clintonelliott23/CT-Monitoring-Assignment/CTM - Operational Images/20171026_112421.jpg

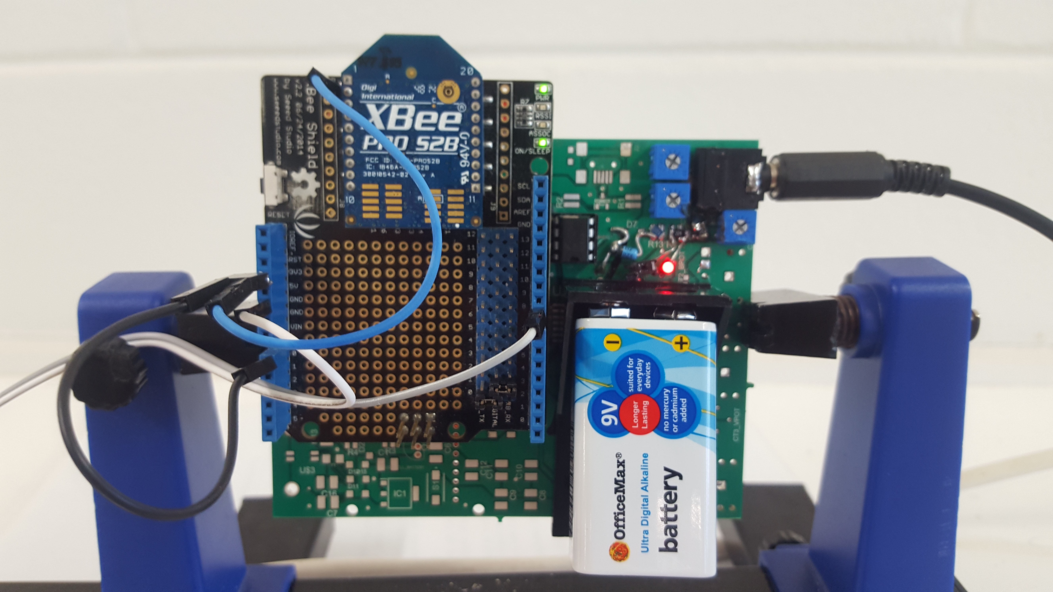
CTM - Operational Images/20171026_112421.jpg
