clintonelliott23/CT-Monitoring-Assignment/CTM - Website HTML Code/CTM-3501 Live Current Sensor (Website)_files/bg3.jpg

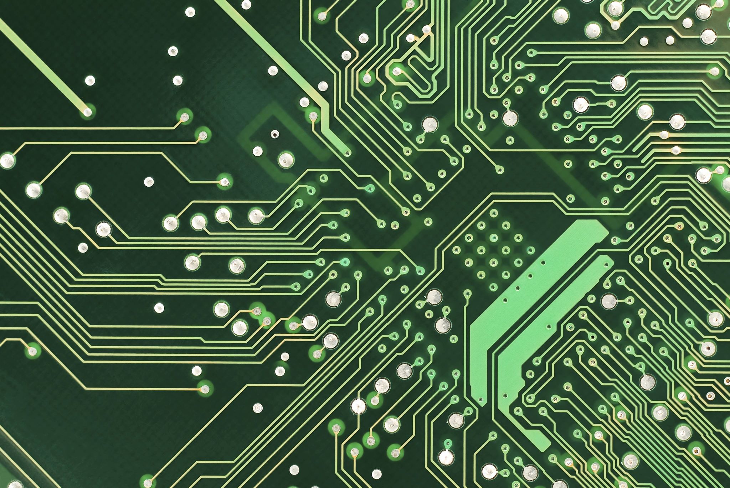
CTM - Website HTML Code/CTM-3501 Live Current Sensor (Website)_files/bg3.jpg
