clintonelliott23/CT-Monitoring-Assignment/CTM - PCB, Schematic & BOM/CC3501-Bill-of-Materials-CT-Metering-PCB_Final.xlsx

EE3501 - CT Metering PCB - Bill Of Materials
 |  |  |  |  |  |  |  |  |  |  | Freedom Schematic |  | C:\Users\Clint\OneDrive\4th Year Sem2\CC3501\Software\FRDM-K20D50M_SCH.pdf
 |  |  |  |  |  |  |  |  | `
Components as listed on Element14:
Order Code | MuF# | Quantity | Part | Description | Size | Mount | Max Voltage | Max Current | Power Draw | Unit price | Total price | Notes | Data Sheets | Element Website
1887096 | MM3Z3V3ST1G | 4 | Zener | ZENER DIODE, 200MW, 3.3V, SOD-323 | Axial | SMD |  |  |  | $0.22 | 0.864 | 100ua leakage 1N4729A | C:\Users\Clint\OneDrive\4th Year Sem2\CC3501\Github\CT-Monitoring-Assignment\Data Sheets\Zener 3.3v.pdf | http://au.element14.com/on-semiconductor/mm3z3v3st1g/zener-diode-200mw-3-3v-sod-323/dp/1887096
1902429 | BZT52C15S | 1 | Zener | Zener Single Diode, 15 V, 200 mW, SOD-323 |  | SMD |  |  |  | $0.54 | 0.535 |  |  | http://au.element14.com/diodes-inc/bzt52c15s/diode-zener-15v-0-2w-sod-323/dp/1902429
8737592 | PESD3V3S2UT | 1 | ESD | ESD Protection Device, TVS, 20 V, SOT-23, 3 Pins |  | SMD | 20 |  |  | $0.13 | 0.133 |  |  | http://au.element14.com/nxp/pesd3v3s2ut/diode-tvs-sot-23/dp/8737592
2409013 | LM358AN | 4 | Op-Amp | OP AMP, DIP-8 |  | DIP | 16 | 0.8ma |  | $0.31 | 1.256 | 15ma output | C:\Users\Clint\OneDrive\4th Year Sem2\CC3501\Github\CT-Monitoring-Assignment\Data Sheets\3.3v opamp.pdf | http://au.element14.com/fairchild-industrial/lm358an/op-amp-dip-8/dp/2409013
2336656 | HEF4066BT,653 | 1 | Mux | Analogue Switch, Quad Channel, SPST, 4 Channels, 175 ohm, 3V to 15V, SOIC, 14 Pins |  | SOIC | 18 | 10ma | 100mw | $0.18 | 0.177 | 10ma output | C:\Users\Clint\OneDrive\4th Year Sem2\CC3501\Github\CT-Monitoring-Assignment\Data Sheets\mux.pdf | http://au.element14.com/nxp/hef4066bt-653/analogue-switch-quad-spst-soic/dp/2336656
 |  |  |  |  |  |  |  |  |  |  | 0
2329885 | LR0204F1K0 | 14 | Resistors | Through Hole Resistor, 1 kohm, 200 V, Axial Leaded, 250 mW |  |  | 200 |  |  |  | 14 |  |  | http://au.element14.com/te-connectivity/lr0204f1k0/resistor-metal-1k0-0-25w-1/dp/2329885
2690182 | MCW0612MC1001FP100 | 2 | Resistors | SMD Chip Resistor, 1 kohm, 75 V, 0612 [1632 Metric], 1 W, |  | SMD |  |  |  | $0.30 | 0.598 |  |  | http://au.element14.com/vishay/mcw0612mc1001fp100/res-aec-q200-1k-1-1w-0612/dp/2690182
2706091 | MCW0612MC2209FP100 | 1 | Resistors | SMD Chip Resistor, 22 ohm, 75 V, 0612 [1632 Metric], 1 W |  |  |  |  |  | $0.81 | 0.81 |  |  | http://au.element14.com/vishay/mcw0612mc2209fp100/res-aec-q200-22r-1-1w-0612/dp/2706091
2706096 | MCW0612MC2000FP100 | 1 | Resistors | SMD Chip Resistor, 200 ohm, 75 V, 0612 [1632 Metric], 1 W |  |  |  |  |  | $0.88 | 0.88 |  |  | http://au.element14.com/vishay/mcw0612mc2000fp100/res-aec-q200-200r-1-1w-0612/dp/2706096
2706092 | MCW0612MC3309FP100 | 2 | Resistors | SMD Chip Resistor, 33 ohm, 75 V, 0612 [1632 Metric], 1 W, |  | SMD |  |  |  | $0.81 | 1.62 |  |  | http://au.element14.com/vishay/mcw0612mc3309fp100/res-aec-q200-33r-1-1w-0612/dp/2706092
2706102 | MCW0612MC4701FP100 | 2 | Resistors | SMD Chip Resistor, 4.7 kohm, 75 V, 0612 [1632 Metric], 1 W, |  | SMD |  |  |  | $0.88 | 1.76 |  |  | http://au.element14.com/vishay/mcw0612mc4701fp100/res-aec-q200-4k7-1-1w-0612/dp/2706102
2706103 | MCW0612MC1002FP100 | 5 | Resistors | SMD Chip Resistor, 10 kohm, 75 V, 0612 [1632 Metric], 1 W, |  | SMD |  |  |  | $0.88 | 4.4 |  |  | http://au.element14.com/vishay/mcw0612mc1002fp100/res-aec-q200-10k-1-1w-0612/dp/2706103
2466724 | 885012209012 | 2 | Capacitors | SMD Multilayer Ceramic Capacitor, 1210 [3225 Metric], 2.2 µF, 16 V |  | SMD |  |  |  | $0.55 | 1.102 |  |  | http://au.element14.com/wurth-elektronik/885012209012/cap-mlcc-x7r-2-2uf-16v-1210/dp/2466724
2466731 | 885012209019 | 2 | Capacitors | SMD Multilayer Ceramic Capacitor, 1210 [3225 Metric], 0.1 µF, 25 V, |  | SMD |  |  |  | $0.30 | 0.6 |  |  | http://au.element14.com/wurth-elektronik/885012209019/cap-mlcc-x7r-0-1uf-25v-1210/dp/2466731
1650910 | C1210C105K5RAC-TU | 8 | Capacitors | SMD Multilayer Ceramic Capacitor, 1210 [3225 Metric], 1 µF, 50 V |  | SMD |  |  |  | $0.48 | 3.84 |  |  | http://au.element14.com/kemet/c1210c105k5rac-tu/capacitor-ceramic-multilayer/dp/1650910
2112728 | C3225X7S1H106K250AB | 2 | Capacitors | SMD Multilayer Ceramic Capacitor, 1210 [3225 Metric], 10 µF, 50 V |  | SMD |  |  |  | $1.39 | 2.78 |  |  | http://au.element14.com/tdk/c3225x7s1h106k250ab/cap-mlcc-x7s-10uf-50v-1210/dp/2112728
9354301 | 3362P-1-103LF | 12 | Potentiometer | Trimmer Potentiometer, 10 kohm, 500 mW |  |  |  |  |  | $1.88 | 22.56
2437102 | SN74LVC125APWR | 1 | NAND Gates | Buffer / Line Driver, 74LVC125, 1.65 V to 3.6 V, TSSOP-14 | SOI | SMD | 6.5 | 100ma | 500mw | $0.18 | 0.185 | clamp 50ma | C:\Users\Clint\OneDrive\4th Year Sem2\CC3501\Github\CT-Monitoring-Assignment\Data Sheets\Nand_gates.pdf | http://au.element14.com/texas-instruments/sn74lvc125apwr/buffer-gate-quad-tri-state-tssop/dp/2437102
2534283 | NCP1117LPST33T3G | 1 | Voltage Reg | Fixed LDO Voltage Regulator, 18V in, 1.3V Dropout, 3.3V/1A out, SOT-223-3 | SOT−223 | SMD | 18 | 1 |  | $0.60 | 0.604 | Min 4.7v | C:\Users\Clint\OneDrive\4th Year Sem2\CC3501\Github\CT-Monitoring-Assignment\Data Sheets\voltagereg.pdf
2533227 (http://au.element14.com/on-semiconductor/mbr120vlsft3g/schottky-rect-1a-20v-sod123/dp/2533227) | MBR120VLSFT3G (http://au.element14.com/on-semiconductor/mbr120vlsft3g/schottky-rect-1a-20v-sod123/dp/2533227) | 2 | Schottky Diodes | Surface Mount Schottky Power Rectifier | SOD-123 | SMD | 20 | 1 |  | $0.61 | 1.22 |  | C:\Users\Clint\OneDrive\4th Year Sem2\CC3501\Github\CT-Monitoring-Assignment\Data Sheets\schotkky diodes.pdf
1822203 | 1206L035/16YR | 1 | Fuse | Resettable PTCs, Surface Mount > 1206L Series | 1206 | SMD |  | 0.5 |  | $0.54 | 0.542 |  | C:\Users\Clint\OneDrive\4th Year Sem2\CC3501\Github\CT-Monitoring-Assignment\Data Sheets\Polyfuse.pdf
9802541 (http://au.element14.com/stmicroelectronics/p0102da-1aa3/thyristor-0-8a-400v-to-92/dp/9802541) | P0102DA 1AA3 (http://au.element14.com/stmicroelectronics/p0102da-1aa3/thyristor-0-8a-400v-to-92/dp/9802541) | 1 | SCR (thyristor) | Thyristor for Crowbar protection | TO-92 | T | 600 | 5 to 200uA |  | $0.69 | 0.69 |  | C:\Users\Clint\OneDrive\4th Year Sem2\CC3501\Github\CT-Monitoring-Assignment\Data Sheets\thyristor.pdf
2133567 | MK20DX128VFM5 | 1 | Processor Main | ARM Microcontroller, K2 USB Series, Kinetis ARM Cortex-M4 Microcontrollers, 32bit, 50 MHz, 128 KB |  |  | 3.6 | 155ma |  | $6.94 | 6.94 |  | C:\Users\Clint\OneDrive\4th Year Sem2\CC3501\Github\CT-Monitoring-Assignment\Data Sheets\freedom_main_process.pdf | http://au.element14.com/nxp/mk20dx128vfm5/mcu-32bit-cortex-m4-50mhz-qfn/dp/2133567?ost=MK20DX128VFM5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
2133572 | MK20DX128VLH5 | 1 | Processor SDA | ARM Microcontroller, K2 USB Series, Kinetis ARM Cortex-M4 Microcontrollers, 32bit, 50 MHz, 128 KB |  |  | 3.6 | 155ma |  | $7.56 | 7.56 |  | C:\Users\Clint\OneDrive\4th Year Sem2\CC3501\Github\CT-Monitoring-Assignment\Data Sheets\SDA processor.pdf | http://au.element14.com/nxp/mk20dx128vlh5/mcu-32bit-cortex-m4-50mhz-lqfp/dp/2133572
2751667 | 1554266-1 | 1 | USB Connector | USB Connector, Micro USB Type B, USB 2.0, Receptacle, 5 Ways, Surface Mount, Right Angle |  | SMD |  |  |  | $1.77 | 1.77 |  |  | http://au.element14.com/amp-te-connectivity/1554266-1/micro-usb-conn-2-0-type-b-rcpt/dp/2751667?ost=1554266-1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
1515663 | BLM21PG331SN1D | 2 | Ferrite Bead | Ferrite Bead, 330 ohm, 0805 [2012 Metric], BLM21P Series, 1.5 A, |  | SMD |  |  |  | $0.08 | 0.158 |  |  | http://au.element14.com/murata/blm21pg331sn1d/ferrite-bead-0805-0-07ohm-1-5a/dp/1515663
 |  |  |  |  |  |  |  |  |  | 0.0405 | 0.0405 |  |  | http://au.element14.com/multicomp/dtsm-32s-b/switch-spno-0-05a-12v-smd/dp/9471898?iscrfnonsku=true
9471898 | DTSM-32S-B | 1 | switch | Tactile Switch, Non Illuminated, 12 V, 50 mA |  |  |  |  |  |  | 1
 |  |  |  |  |  |  |  |  |  |  | 0
8554609 | HSMG-C190. | 5 | LED | LED, Green, SMD, 0.8mm x 1.6mm, 25 mA, 2.2 V |  |  |  |  |  | $0.70 | 3.48 |  |  | http://au.element14.com/broadcom-limited/hsmg-c190/led-green-15mcd-572nm/dp/2497374
1208855 |  | 2 |  | LED, Red, Through Hole |  |  |  |  |  | $0.77 | 1.536 | *AC indication
Total Items: |  | 83 |  |  |  |  | Total Price: |  |  |  | $83.64
HEADER |  | 1 |  | 1x30 Header |  |  |  |  |  | $2.50 | 2.5 | *Only need 11
Total Items: |  | 1 |  |  |  |  | Total Price: |  |  |  | $2.50
