clintonelliott23/CT-Monitoring-Assignment/CTM - Kinetis Code/Documentation/doxygen/AdcLdd1_component.txt

/*!
  \page AdcLdd1 AdcLdd1 (ADC_LDD)
**         This device "ADC_LDD" implements an A/D converter,
**         its control methods and interrupt/event handling procedure.
**

- \subpage AdcLdd1_settings
- \subpage AdcLdd1_regs_overview  
- \subpage AdcLdd1_regs_details
- \ref AdcLdd1_module "Component documentation" 
\page AdcLdd1_regs_overview Registers Initialization Overview
This page contains the initialization values for the registers of the peripheral(s) configured
by the component. 
<table>
<tr><td colspan="4" class="ttitle1">AdcLdd1 Initialization</td></tr>
<tr><td class="ttitle2">Address</td><td class="ttitle2">Register</td><td class="ttitle2">Register Value</td><td class="ttitle2">Register Description</td></tr>
<tr><td>0x4003B000</td><td>ADC0_SC1A</td>
<td class="regNotResetVal">0x00000057</td>
 <td>ADC0_SC1A register, peripheral AdcLdd1.</td></tr>
<tr><td>0x4004803C</td><td>SIM_SCGC6</td>
<td class="regNotResetVal">0x4A000001</td>
 <td>SIM_SCGC6 register, peripheral AdcLdd1.</td></tr>
<tr><td>0xE000E416</td><td>NVICIP22</td>
<td class="regNotResetVal">0x00000080</td>
 <td>NVICIP22 register, peripheral AdcLdd1.</td></tr>
<tr><td>0xE000E100</td><td>NVICISER0</td>
<td class="regNotResetVal">0x044F0000</td>
 <td>NVICISER0 register, peripheral AdcLdd1.</td></tr>
<tr><td>0x4003B008</td><td>ADC0_CFG1</td>
<td class="regNotResetVal">0x0000004C</td>
 <td>ADC0_CFG1 register, peripheral AdcLdd1.</td></tr>
<tr><td>0x4003B00C</td><td>ADC0_CFG2</td>
<td class="regResetVal">0x00000000</td>
 <td>ADC0_CFG2 register, peripheral AdcLdd1.</td></tr>
<tr><td>0x4003B020</td><td>ADC0_SC2</td>
<td class="regResetVal">0x00000000</td>
 <td>ADC0_SC2 register, peripheral AdcLdd1.</td></tr>
<tr><td>0x4003B024</td><td>ADC0_SC3</td>
<td class="regNotResetVal">0x00000040</td>
 <td>ADC0_SC3 register, peripheral AdcLdd1.</td></tr>
</table>
Color Denotes Reset Value
<br/>
\page AdcLdd1_regs_details Register Initialization Details
This page contains detailed description of initialization values for the 
registers of the peripheral(s) configured by the component. 

<div class="reghdr1">ADC0_SC1A</div>
<div class="regdiag">
<table class="regtbl">
<tr class="trd1r">
<td class="trd1c">Bit</td><td>31</td><td>30</td><td>29</td><td>28</td><td>27</td><td>26</td><td>25</td><td>24</td><td>23</td>
<td>22</td><td>21</td><td>20</td><td>19</td><td>18</td><td>17</td><td>16</td>
</tr>
<tr>
<td class="trd1c">R</td><td colspan="1" rowspan="2">-</td><td colspan="1" rowspan="2">-</td><td colspan="1" rowspan="2">-</td>
<td colspan="1" rowspan="2">-</td><td colspan="1" rowspan="2">-</td><td colspan="1" rowspan="2">-</td>
<td colspan="1" rowspan="2">-</td><td colspan="1" rowspan="2">-</td><td colspan="1" rowspan="2">-</td>
<td colspan="1" rowspan="2">-</td><td colspan="1" rowspan="2">-</td><td colspan="1" rowspan="2">-</td>
<td colspan="1" rowspan="2">-</td><td colspan="1" rowspan="2">-</td><td colspan="1" rowspan="2">-</td>
<td colspan="1" rowspan="2">-</td>
</tr>
<tr>
<td class="trd1c">W</td>
</tr>
<tr class="trd1r">
<td class="trd1c">Reset</td><td>0</td><td>0</td><td>0</td><td>0</td><td>0</td><td>0</td><td>0</td><td>0</td><td>0</td><td>0</td>
<td>0</td><td>0</td><td>0</td><td>0</td><td>0</td><td>0</td>
</tr>
</table>
<table class="regtbl">
<tr class="trd1r">
<td class="trd1c">Bit</td><td>15</td><td>14</td><td>13</td><td>12</td><td>11</td><td>10</td><td>9</td><td>8</td><td>7</td>
<td>6</td><td>5</td><td>4</td><td>3</td><td>2</td><td>1</td><td>0</td>
</tr>
<tr>
<td class="trd1c">R</td><td colspan="1" rowspan="2">-</td><td colspan="1" rowspan="2">-</td><td colspan="1" rowspan="2">-</td>
<td colspan="1" rowspan="2">-</td><td colspan="1" rowspan="2">-</td><td colspan="1" rowspan="2">-</td>
<td colspan="1" rowspan="2">-</td><td colspan="1" rowspan="2">-</td><td colspan="1" rowspan="1">COCO</td>
<td colspan="1" rowspan="2">AIEN</td><td colspan="1" rowspan="2">DIFF</td><td colspan="5" rowspan="2">ADCH</td>
</tr>
<tr>
<td class="trd1c">W</td>
<td colspan="1"></td>
</tr>
<tr class="trd1r">
<td class="trd1c">Reset</td><td>0</td><td>0</td><td>0</td><td>0</td><td>0</td><td>0</td><td>0</td><td>0</td><td>0</td><td>0</td>
<td>0</td><td>1</td><td>1</td><td>1</td><td>1</td><td>1</td>
</tr>
</table>
        
</div>
<table class="regtbl2"><tr><td class="trowtit" colspan="2">Address</td><td colspan="2">0x4003B000</td></tr>
<tr class="trowtit"><td  class="trowtit" colspan="2">Initial value</td><td colspan="2">0x00000057</td></tr>
<tr class="trowtit"><td  class="trowtit" colspan="2">After-reset value</td><td colspan="2">0x0000001F</td></tr>
<tr><td class="ttitle2">Bit</td><td class="ttitle2">Field</td><td class="ttitle2">Value</td><td class="ttitle2">Description</td></tr>
<tr><td>7</td><td>COCO</td><td>0x00</td><td>Conversion complete flag</td>
<tr><td>6</td><td>AIEN</td><td>0x01</td><td>Interrupt enable</td>
<tr><td>5</td><td>DIFF</td><td>0x00</td><td>Differential mode enable</td>
<tr><td>0 - 4</td><td>ADCH</td><td>0x10</td><td>Input channel select</td>
</tr></table>
<div class="reghdr1">SIM_SCGC6</div>
<div class="regdiag">
<table class="regtbl">
<tr class="trd1r">
<td class="trd1c">Bit</td><td>31</td><td>30</td><td>29</td><td>28</td><td>27</td><td>26</td><td>25</td><td>24</td><td>23</td>
<td>22</td><td>21</td><td>20</td><td>19</td><td>18</td><td>17</td><td>16</td>
</tr>
<tr>
<td class="trd1c">R</td><td colspan="1" rowspan="2">-</td><td colspan="1" rowspan="2">-</td><td colspan="1" rowspan="2">RTC</td>
<td colspan="1" rowspan="2">-</td><td colspan="1" rowspan="2">ADC0</td><td colspan="1" rowspan="2">-</td>
<td colspan="1" rowspan="2">FTM1</td><td colspan="1" rowspan="2">FTM0</td><td colspan="1" rowspan="2">PIT</td>
<td colspan="1" rowspan="2">PDB</td><td colspan="1" rowspan="2">USBDCD</td><td colspan="1" rowspan="2">-</td>
<td colspan="1" rowspan="2">-</td><td colspan="1" rowspan="2">CRC</td><td colspan="1" rowspan="2">-</td>
<td colspan="1" rowspan="2">-</td>
</tr>
<tr>
<td class="trd1c">W</td>
</tr>
<tr class="trd1r">
<td class="trd1c">Reset</td><td>0</td><td>1</td><td>0</td><td>0</td><td>0</td><td>0</td><td>0</td><td>0</td><td>0</td><td>0</td>
<td>0</td><td>0</td><td>0</td><td>0</td><td>0</td><td>0</td>
</tr>
</table>
<table class="regtbl">
<tr class="trd1r">
<td class="trd1c">Bit</td><td>15</td><td>14</td><td>13</td><td>12</td><td>11</td><td>10</td><td>9</td><td>8</td><td>7</td>
<td>6</td><td>5</td><td>4</td><td>3</td><td>2</td><td>1</td><td>0</td>
</tr>
<tr>
<td class="trd1c">R</td><td colspan="1" rowspan="2">I2S</td><td colspan="1" rowspan="2">-</td><td colspan="1" rowspan="2">-</td>
<td colspan="1" rowspan="2">SPI0</td><td colspan="1" rowspan="2">-</td><td colspan="1" rowspan="2">-</td>
<td colspan="1" rowspan="2">-</td><td colspan="1" rowspan="2">-</td><td colspan="1" rowspan="2">-</td>
<td colspan="1" rowspan="2">-</td><td colspan="1" rowspan="2">-</td><td colspan="1" rowspan="2">-</td>
<td colspan="1" rowspan="2">-</td><td colspan="1" rowspan="2">-</td><td colspan="1" rowspan="2">DMAMUX</td>
<td colspan="1" rowspan="2">FTFL</td>
</tr>
<tr>
<td class="trd1c">W</td>
</tr>
<tr class="trd1r">
<td class="trd1c">Reset</td><td>0</td><td>0</td><td>0</td><td>0</td><td>0</td><td>0</td><td>0</td><td>0</td><td>0</td><td>0</td>
<td>0</td><td>0</td><td>0</td><td>0</td><td>0</td><td>1</td>
</tr>
</table>
        
</div>
<table class="regtbl2"><tr><td class="trowtit" colspan="2">Address</td><td colspan="2">0x4004803C</td></tr>
<tr class="trowtit"><td  class="trowtit" colspan="2">Initial value</td><td colspan="2">0x4A000001</td></tr>
<tr class="trowtit"><td  class="trowtit" colspan="2">After-reset value</td><td colspan="2">0x40000001</td></tr>
<tr><td class="ttitle2">Bit</td><td class="ttitle2">Field</td><td class="ttitle2">Value</td><td class="ttitle2">Description</td></tr>
<tr><td>29</td><td>RTC</td><td>0x00</td><td>RTC Access Control</td>
<tr><td>27</td><td>ADC0</td><td>0x01</td><td>ADC0 Clock Gate Control</td>
<tr><td>25</td><td>FTM1</td><td>0x01</td><td>FTM1 Clock Gate Control</td>
<tr><td>24</td><td>FTM0</td><td>0x00</td><td>FTM0 Clock Gate Control</td>
<tr><td>23</td><td>PIT</td><td>0x00</td><td>PIT Clock Gate Control</td>
<tr><td>22</td><td>PDB</td><td>0x00</td><td>PDB Clock Gate Control</td>
<tr><td>21</td><td>USBDCD</td><td>0x00</td><td>USB DCD Clock Gate Control</td>
<tr><td>18</td><td>CRC</td><td>0x00</td><td>CRC Clock Gate Control</td>
<tr><td>15</td><td>I2S</td><td>0x00</td><td>I2S Clock Gate Control</td>
<tr><td>12</td><td>SPI0</td><td>0x00</td><td>SPI0 Clock Gate Control</td>
<tr><td>1</td><td>DMAMUX</td><td>0x00</td><td>DMA Mux Clock Gate Control</td>
<tr><td>0</td><td>FTFL</td><td>0x01</td><td>Flash Memory Clock Gate Control</td>
</tr></table>
<div class="reghdr1">NVICIP22</div>
<div class="regdiag">
<table class="regtbl">
<tr class="trd1r">
<td class="trd1c">Bit</td><td>7</td><td>6</td><td>5</td><td>4</td><td>3</td><td>2</td><td>1</td><td>0</td>
</tr>
<tr>
<td class="trd1c">R</td><td colspan="8" rowspan="2">PRI22</td>
</tr>
<tr>
<td class="trd1c">W</td>
</tr>
<tr class="trd1r">
<td class="trd1c">Reset</td><td>0</td><td>0</td><td>0</td><td>0</td><td>0</td><td>0</td><td>0</td><td>0</td>
</tr>
</table>
        
</div>
<table class="regtbl2"><tr><td class="trowtit" colspan="2">Address</td><td colspan="2">0xE000E416</td></tr>
<tr class="trowtit"><td  class="trowtit" colspan="2">Initial value</td><td colspan="2">0x00000080</td></tr>
<tr class="trowtit"><td  class="trowtit" colspan="2">After-reset value</td><td colspan="2">0x00000000</td></tr>
<tr><td class="ttitle2">Bit</td><td class="ttitle2">Field</td><td class="ttitle2">Value</td><td class="ttitle2">Description</td></tr>
<tr><td>0 - 7</td><td>PRI22</td><td>0x80</td><td>Priority of interrupt 22</td>
</tr></table>
<div class="reghdr1">NVICISER0</div>
<div class="regdiag">
<table class="regtbl">
<tr class="trd1r">
<td class="trd1c">Bit</td><td>31</td><td>30</td><td>29</td><td>28</td><td>27</td><td>26</td><td>25</td><td>24</td><td>23</td>
<td>22</td><td>21</td><td>20</td><td>19</td><td>18</td><td>17</td><td>16</td>
</tr>
<tr>
<td class="trd1c">R</td><td colspan="16" rowspan="2">SETENA</td>
</tr>
<tr>
<td class="trd1c">W</td>
</tr>
<tr class="trd1r">
<td class="trd1c">Reset</td><td>0</td><td>0</td><td>0</td><td>0</td><td>0</td><td>0</td><td>0</td><td>0</td><td>0</td><td>0</td>
<td>0</td><td>0</td><td>0</td><td>0</td><td>0</td><td>0</td>
</tr>
</table>
<table class="regtbl">
<tr class="trd1r">
<td class="trd1c">Bit</td><td>15</td><td>14</td><td>13</td><td>12</td><td>11</td><td>10</td><td>9</td><td>8</td><td>7</td>
<td>6</td><td>5</td><td>4</td><td>3</td><td>2</td><td>1</td><td>0</td>
</tr>
<tr>
<td class="trd1c">R</td><td colspan="32" rowspan="2">SETENA</td>
</tr>
<tr>
<td class="trd1c">W</td>
</tr>
<tr class="trd1r">
<td class="trd1c">Reset</td><td>0</td><td>0</td><td>0</td><td>0</td><td>0</td><td>0</td><td>0</td><td>0</td><td>0</td><td>0</td>
<td>0</td><td>0</td><td>0</td><td>0</td><td>0</td><td>0</td>
</tr>
</table>
        
</div>
<table class="regtbl2"><tr><td class="trowtit" colspan="2">Address</td><td colspan="2">0xE000E100</td></tr>
<tr class="trowtit"><td  class="trowtit" colspan="2">Initial value</td><td colspan="2">0x044F0000</td></tr>
<tr class="trowtit"><td  class="trowtit" colspan="2">After-reset value</td><td colspan="2">0x00000000</td></tr>
<tr><td class="ttitle2">Bit</td><td class="ttitle2">Field</td><td class="ttitle2">Value</td><td class="ttitle2">Description</td></tr>
<tr><td>0 - 31</td><td>SETENA</td><td>0x00</td><td>Interrupt set enable bits</td>
</tr></table>
<div class="reghdr1">ADC0_CFG1</div>
<div class="regdiag">
<table class="regtbl">
<tr class="trd1r">
<td class="trd1c">Bit</td><td>31</td><td>30</td><td>29</td><td>28</td><td>27</td><td>26</td><td>25</td><td>24</td><td>23</td>
<td>22</td><td>21</td><td>20</td><td>19</td><td>18</td><td>17</td><td>16</td>
</tr>
<tr>
<td class="trd1c">R</td><td colspan="1" rowspan="2">-</td><td colspan="1" rowspan="2">-</td><td colspan="1" rowspan="2">-</td>
<td colspan="1" rowspan="2">-</td><td colspan="1" rowspan="2">-</td><td colspan="1" rowspan="2">-</td>
<td colspan="1" rowspan="2">-</td><td colspan="1" rowspan="2">-</td><td colspan="1" rowspan="2">-</td>
<td colspan="1" rowspan="2">-</td><td colspan="1" rowspan="2">-</td><td colspan="1" rowspan="2">-</td>
<td colspan="1" rowspan="2">-</td><td colspan="1" rowspan="2">-</td><td colspan="1" rowspan="2">-</td>
<td colspan="1" rowspan="2">-</td>
</tr>
<tr>
<td class="trd1c">W</td>
</tr>
<tr class="trd1r">
<td class="trd1c">Reset</td><td>0</td><td>0</td><td>0</td><td>0</td><td>0</td><td>0</td><td>0</td><td>0</td><td>0</td><td>0</td>
<td>0</td><td>0</td><td>0</td><td>0</td><td>0</td><td>0</td>
</tr>
</table>
<table class="regtbl">
<tr class="trd1r">
<td class="trd1c">Bit</td><td>15</td><td>14</td><td>13</td><td>12</td><td>11</td><td>10</td><td>9</td><td>8</td><td>7</td>
<td>6</td><td>5</td><td>4</td><td>3</td><td>2</td><td>1</td><td>0</td>
</tr>
<tr>
<td class="trd1c">R</td><td colspan="1" rowspan="2">-</td><td colspan="1" rowspan="2">-</td><td colspan="1" rowspan="2">-</td>
<td colspan="1" rowspan="2">-</td><td colspan="1" rowspan="2">-</td><td colspan="1" rowspan="2">-</td>
<td colspan="1" rowspan="2">-</td><td colspan="1" rowspan="2">-</td><td colspan="1" rowspan="2">ADLPC</td>
<td colspan="2" rowspan="2">ADIV</td><td colspan="1" rowspan="2">ADLSMP</td><td colspan="2" rowspan="2">MODE</td>
<td colspan="2" rowspan="2">ADICLK</td>
</tr>
<tr>
<td class="trd1c">W</td>
</tr>
<tr class="trd1r">
<td class="trd1c">Reset</td><td>0</td><td>0</td><td>0</td><td>0</td><td>0</td><td>0</td><td>0</td><td>0</td><td>0</td><td>0</td>
<td>0</td><td>0</td><td>0</td><td>0</td><td>0</td><td>0</td>
</tr>
</table>
        
</div>
<table class="regtbl2"><tr><td class="trowtit" colspan="2">Address</td><td colspan="2">0x4003B008</td></tr>
<tr class="trowtit"><td  class="trowtit" colspan="2">Initial value</td><td colspan="2">0x0000004C</td></tr>
<tr class="trowtit"><td  class="trowtit" colspan="2">After-reset value</td><td colspan="2">0x00000000</td></tr>
<tr><td class="ttitle2">Bit</td><td class="ttitle2">Field</td><td class="ttitle2">Value</td><td class="ttitle2">Description</td></tr>
<tr><td>7</td><td>ADLPC</td><td>0x00</td><td>Low-power configuration</td>
<tr><td>5 - 6</td><td>ADIV</td><td>0x02</td><td>Clock divide select</td>
<tr><td>4</td><td>ADLSMP</td><td>0x00</td><td>Sample time configuration</td>
<tr><td>2 - 3</td><td>MODE</td><td>0x02</td><td>Conversion mode selection</td>
<tr><td>0 - 1</td><td>ADICLK</td><td>0x00</td><td>Input clock select</td>
</tr></table>
<div class="reghdr1">ADC0_CFG2</div>
<div class="regdiag">
<table class="regtbl">
<tr class="trd1r">
<td class="trd1c">Bit</td><td>31</td><td>30</td><td>29</td><td>28</td><td>27</td><td>26</td><td>25</td><td>24</td><td>23</td>
<td>22</td><td>21</td><td>20</td><td>19</td><td>18</td><td>17</td><td>16</td>
</tr>
<tr>
<td class="trd1c">R</td><td colspan="1" rowspan="2">-</td><td colspan="1" rowspan="2">-</td><td colspan="1" rowspan="2">-</td>
<td colspan="1" rowspan="2">-</td><td colspan="1" rowspan="2">-</td><td colspan="1" rowspan="2">-</td>
<td colspan="1" rowspan="2">-</td><td colspan="1" rowspan="2">-</td><td colspan="1" rowspan="2">-</td>
<td colspan="1" rowspan="2">-</td><td colspan="1" rowspan="2">-</td><td colspan="1" rowspan="2">-</td>
<td colspan="1" rowspan="2">-</td><td colspan="1" rowspan="2">-</td><td colspan="1" rowspan="2">-</td>
<td colspan="1" rowspan="2">-</td>
</tr>
<tr>
<td class="trd1c">W</td>
</tr>
<tr class="trd1r">
<td class="trd1c">Reset</td><td>0</td><td>0</td><td>0</td><td>0</td><td>0</td><td>0</td><td>0</td><td>0</td><td>0</td><td>0</td>
<td>0</td><td>0</td><td>0</td><td>0</td><td>0</td><td>0</td>
</tr>
</table>
<table class="regtbl">
<tr class="trd1r">
<td class="trd1c">Bit</td><td>15</td><td>14</td><td>13</td><td>12</td><td>11</td><td>10</td><td>9</td><td>8</td><td>7</td>
<td>6</td><td>5</td><td>4</td><td>3</td><td>2</td><td>1</td><td>0</td>
</tr>
<tr>
<td class="trd1c">R</td><td colspan="1" rowspan="2">-</td><td colspan="1" rowspan="2">-</td><td colspan="1" rowspan="2">-</td>
<td colspan="1" rowspan="2">-</td><td colspan="1" rowspan="2">-</td><td colspan="1" rowspan="2">-</td>
<td colspan="1" rowspan="2">-</td><td colspan="1" rowspan="2">-</td><td colspan="1" rowspan="2">-</td>
<td colspan="1" rowspan="2">-</td><td colspan="1" rowspan="2">-</td><td colspan="1" rowspan="2">MUXSEL</td>
<td colspan="1" rowspan="2">ADACKEN</td><td colspan="1" rowspan="2">ADHSC</td><td colspan="2" rowspan="2">ADLSTS</td>
</tr>
<tr>
<td class="trd1c">W</td>
</tr>
<tr class="trd1r">
<td class="trd1c">Reset</td><td>0</td><td>0</td><td>0</td><td>0</td><td>0</td><td>0</td><td>0</td><td>0</td><td>0</td><td>0</td>
<td>0</td><td>0</td><td>0</td><td>0</td><td>0</td><td>0</td>
</tr>
</table>
        
</div>
<table class="regtbl2"><tr><td class="trowtit" colspan="2">Address</td><td colspan="2">0x4003B00C</td></tr>
<tr class="trowtit"><td  class="trowtit" colspan="2">Initial value</td><td colspan="2">0x00000000</td></tr>
<tr class="trowtit"><td  class="trowtit" colspan="2">After-reset value</td><td colspan="2">0x00000000</td></tr>
<tr><td class="ttitle2">Bit</td><td class="ttitle2">Field</td><td class="ttitle2">Value</td><td class="ttitle2">Description</td></tr>
<tr><td>4</td><td>MUXSEL</td><td>0x00</td><td>ADC Mux select</td>
<tr><td>3</td><td>ADACKEN</td><td>0x00</td><td>Asynchronous clock output enable</td>
<tr><td>2</td><td>ADHSC</td><td>0x00</td><td>High speed configuration</td>
<tr><td>0 - 1</td><td>ADLSTS</td><td>0x00</td><td>Long sample time select</td>
</tr></table>
<div class="reghdr1">ADC0_SC2</div>
<div class="regdiag">
<table class="regtbl">
<tr class="trd1r">
<td class="trd1c">Bit</td><td>31</td><td>30</td><td>29</td><td>28</td><td>27</td><td>26</td><td>25</td><td>24</td><td>23</td>
<td>22</td><td>21</td><td>20</td><td>19</td><td>18</td><td>17</td><td>16</td>
</tr>
<tr>
<td class="trd1c">R</td><td colspan="1" rowspan="2">-</td><td colspan="1" rowspan="2">-</td><td colspan="1" rowspan="2">-</td>
<td colspan="1" rowspan="2">-</td><td colspan="1" rowspan="2">-</td><td colspan="1" rowspan="2">-</td>
<td colspan="1" rowspan="2">-</td><td colspan="1" rowspan="2">-</td><td colspan="1" rowspan="2">-</td>
<td colspan="1" rowspan="2">-</td><td colspan="1" rowspan="2">-</td><td colspan="1" rowspan="2">-</td>
<td colspan="1" rowspan="2">-</td><td colspan="1" rowspan="2">-</td><td colspan="1" rowspan="2">-</td>
<td colspan="1" rowspan="2">-</td>
</tr>
<tr>
<td class="trd1c">W</td>
</tr>
<tr class="trd1r">
<td class="trd1c">Reset</td><td>0</td><td>0</td><td>0</td><td>0</td><td>0</td><td>0</td><td>0</td><td>0</td><td>0</td><td>0</td>
<td>0</td><td>0</td><td>0</td><td>0</td><td>0</td><td>0</td>
</tr>
</table>
<table class="regtbl">
<tr class="trd1r">
<td class="trd1c">Bit</td><td>15</td><td>14</td><td>13</td><td>12</td><td>11</td><td>10</td><td>9</td><td>8</td><td>7</td>
<td>6</td><td>5</td><td>4</td><td>3</td><td>2</td><td>1</td><td>0</td>
</tr>
<tr>
<td class="trd1c">R</td><td colspan="1" rowspan="2">-</td><td colspan="1" rowspan="2">-</td><td colspan="1" rowspan="2">-</td>
<td colspan="1" rowspan="2">-</td><td colspan="1" rowspan="2">-</td><td colspan="1" rowspan="2">-</td>
<td colspan="1" rowspan="2">-</td><td colspan="1" rowspan="2">-</td><td colspan="1" rowspan="1">ADACT</td>
<td colspan="1" rowspan="2">ADTRG</td><td colspan="1" rowspan="2">ACFE</td><td colspan="1" rowspan="2">ACFGT</td>
<td colspan="1" rowspan="2">ACREN</td><td colspan="1" rowspan="2">DMAEN</td><td colspan="2" rowspan="2">REFSEL</td>
</tr>
<tr>
<td class="trd1c">W</td>
<td colspan="1"></td>
</tr>
<tr class="trd1r">
<td class="trd1c">Reset</td><td>0</td><td>0</td><td>0</td><td>0</td><td>0</td><td>0</td><td>0</td><td>0</td><td>0</td><td>0</td>
<td>0</td><td>0</td><td>0</td><td>0</td><td>0</td><td>0</td>
</tr>
</table>
        
</div>
<table class="regtbl2"><tr><td class="trowtit" colspan="2">Address</td><td colspan="2">0x4003B020</td></tr>
<tr class="trowtit"><td  class="trowtit" colspan="2">Initial value</td><td colspan="2">0x00000000</td></tr>
<tr class="trowtit"><td  class="trowtit" colspan="2">After-reset value</td><td colspan="2">0x00000000</td></tr>
<tr><td class="ttitle2">Bit</td><td class="ttitle2">Field</td><td class="ttitle2">Value</td><td class="ttitle2">Description</td></tr>
<tr><td>7</td><td>ADACT</td><td>0x00</td><td>Conversion active</td>
<tr><td>6</td><td>ADTRG</td><td>0x00</td><td>Conversion trigger select</td>
<tr><td>5</td><td>ACFE</td><td>0x00</td><td>Compare function enable</td>
<tr><td>4</td><td>ACFGT</td><td>0x00</td><td>Compare function greater than enable</td>
<tr><td>3</td><td>ACREN</td><td>0x00</td><td>Compare function range enable</td>
<tr><td>2</td><td>DMAEN</td><td>0x00</td><td>DMA enable</td>
<tr><td>0 - 1</td><td>REFSEL</td><td>0x00</td><td>Voltage reference selection</td>
</tr></table>
<div class="reghdr1">ADC0_SC3</div>
<div class="regdiag">
<table class="regtbl">
<tr class="trd1r">
<td class="trd1c">Bit</td><td>31</td><td>30</td><td>29</td><td>28</td><td>27</td><td>26</td><td>25</td><td>24</td><td>23</td>
<td>22</td><td>21</td><td>20</td><td>19</td><td>18</td><td>17</td><td>16</td>
</tr>
<tr>
<td class="trd1c">R</td><td colspan="1" rowspan="2">-</td><td colspan="1" rowspan="2">-</td><td colspan="1" rowspan="2">-</td>
<td colspan="1" rowspan="2">-</td><td colspan="1" rowspan="2">-</td><td colspan="1" rowspan="2">-</td>
<td colspan="1" rowspan="2">-</td><td colspan="1" rowspan="2">-</td><td colspan="1" rowspan="2">-</td>
<td colspan="1" rowspan="2">-</td><td colspan="1" rowspan="2">-</td><td colspan="1" rowspan="2">-</td>
<td colspan="1" rowspan="2">-</td><td colspan="1" rowspan="2">-</td><td colspan="1" rowspan="2">-</td>
<td colspan="1" rowspan="2">-</td>
</tr>
<tr>
<td class="trd1c">W</td>
</tr>
<tr class="trd1r">
<td class="trd1c">Reset</td><td>0</td><td>0</td><td>0</td><td>0</td><td>0</td><td>0</td><td>0</td><td>0</td><td>0</td><td>0</td>
<td>0</td><td>0</td><td>0</td><td>0</td><td>0</td><td>0</td>
</tr>
</table>
<table class="regtbl">
<tr class="trd1r">
<td class="trd1c">Bit</td><td>15</td><td>14</td><td>13</td><td>12</td><td>11</td><td>10</td><td>9</td><td>8</td><td>7</td>
<td>6</td><td>5</td><td>4</td><td>3</td><td>2</td><td>1</td><td>0</td>
</tr>
<tr>
<td class="trd1c">R</td><td colspan="1" rowspan="2">-</td><td colspan="1" rowspan="2">-</td><td colspan="1" rowspan="2">-</td>
<td colspan="1" rowspan="2">-</td><td colspan="1" rowspan="2">-</td><td colspan="1" rowspan="2">-</td>
<td colspan="1" rowspan="2">-</td><td colspan="1" rowspan="2">-</td><td colspan="1" rowspan="2">CAL</td>
<td colspan="1" rowspan="2">CALF</td><td colspan="1" rowspan="2">-</td><td colspan="1" rowspan="2">-</td>
<td colspan="1" rowspan="2">ADCO</td><td colspan="1" rowspan="2">AVGE</td><td colspan="2" rowspan="2">AVGS</td>
</tr>
<tr>
<td class="trd1c">W</td>
</tr>
<tr class="trd1r">
<td class="trd1c">Reset</td><td>0</td><td>0</td><td>0</td><td>0</td><td>0</td><td>0</td><td>0</td><td>0</td><td>0</td><td>0</td>
<td>0</td><td>0</td><td>0</td><td>0</td><td>0</td><td>0</td>
</tr>
</table>
        
</div>
<table class="regtbl2"><tr><td class="trowtit" colspan="2">Address</td><td colspan="2">0x4003B024</td></tr>
<tr class="trowtit"><td  class="trowtit" colspan="2">Initial value</td><td colspan="2">0x00000040</td></tr>
<tr class="trowtit"><td  class="trowtit" colspan="2">After-reset value</td><td colspan="2">0x00000000</td></tr>
<tr><td class="ttitle2">Bit</td><td class="ttitle2">Field</td><td class="ttitle2">Value</td><td class="ttitle2">Description</td></tr>
<tr><td>7</td><td>CAL</td><td>0x00</td><td>Calibration</td>
<tr><td>6</td><td>CALF</td><td>0x01</td><td>Calibration failed flag</td>
<tr><td>3</td><td>ADCO</td><td>0x00</td><td>Continuous conversion enable</td>
<tr><td>2</td><td>AVGE</td><td>0x00</td><td>Hardware average enable</td>
<tr><td>0 - 1</td><td>AVGS</td><td>0x00</td><td>Hardware average select</td>
</tr></table>
*/
/*!
\page AdcLdd1_settings Component Settings
\code
**          Component name                                 : AdcLdd1
**          A/D converter                                  : ADC0
**          Discontinuous mode                             : no
**          Interrupt service/event                        : Enabled
**            A/D interrupt                                : INT_ADC0
**            A/D interrupt priority                       : medium priority
**          DMA                                            : Disabled
**          A/D channel list                               : 4
**            Channel 0                                    : 
**              Channel mode                               : Single Ended
**                Input                                    : 
**                  A/D channel (pin)                      : ADC0_DP0
**                  A/D channel (pin) signal               : 
**            Channel 1                                    : 
**              Channel mode                               : Single Ended
**                Input                                    : 
**                  A/D channel (pin)                      : ADC0_DM0
**                  A/D channel (pin) signal               : 
**            Channel 2                                    : 
**              Channel mode                               : Single Ended
**                Input                                    : 
**                  A/D channel (pin)                      : ADC0_DM3
**                  A/D channel (pin) signal               : 
**            Channel 3                                    : 
**              Channel mode                               : Single Ended
**                Input                                    : 
**                  A/D channel (pin)                      : ADC0_DP3
**                  A/D channel (pin) signal               : 
**          Static sample groups                           : Disabled
**          Max. samples                                   : 8
**          A/D resolution                                 : Autoselect
**          Low-power mode                                 : Disabled
**          High-speed conversion mode                     : Disabled
**          Asynchro clock output                          : Disabled
**          Sample time                                    : 4 clock periods
**          Number of conversions                          : 1
**          Conversion time                                : 4.768372 µs
**          ADC clock                                      : 5.242 MHz (190.735 ns)
**          Single conversion time - Single-ended          : 5.96 us
**          Single conversion time - Differential          : 7.677 us
**          Additional conversion time - Single-ended      : 4.768 us
**          Additional conversion time - Differential      : 6.484 us
**          Result type                                    : unsigned 16 bits, right justified
**          Trigger                                        : Disabled
**          Voltage reference                              : 
**            High voltage reference                       : 
**              Volt. ref. pin                             : VREFH
**              Volt. ref pin signal                       : 
**            Low voltage reference                        : 
**              Volt. ref. pin                             : VREFL
**              Volt. ref pin signal                       : 
**          Initialization                                 : 
**            Enabled in init. code                        : yes
**            Auto initialization                          : no
**            Event mask                                   : 
**              OnMeasurementComplete                      : Enabled
**              OnError                                    : Disabled
**          CPU clock/configuration selection              : 
**            Clock configuration 0                        : This component enabled
**            Clock configuration 1                        : This component disabled
**            Clock configuration 2                        : This component disabled
**            Clock configuration 3                        : This component disabled
**            Clock configuration 4                        : This component disabled
**            Clock configuration 5                        : This component disabled
**            Clock configuration 6                        : This component disabled
**            Clock configuration 7                        : This component disabled
<h1>
\endcode
*/
