clintonelliott23/CT-Monitoring-Assignment/CTM - Kinetis Code/Documentation/doxygen/ASerialLdd1_component.txt

/*!
  \page ASerialLdd1 ASerialLdd1 (Serial_LDD)
**         This component "Serial_LDD" implements an asynchronous serial
**         communication. The component supports different settings of
**         parity, word width, stop-bit and communication speed,
**         user can select interrupt or polling handler.
**         Communication speed can be changed also in runtime.
**         The component requires one on-chip asynchronous serial communication channel.
**

- \subpage ASerialLdd1_settings
- \subpage ASerialLdd1_regs_overview  
- \subpage ASerialLdd1_regs_details
- \ref ASerialLdd1_module "Component documentation" 
\page ASerialLdd1_regs_overview Registers Initialization Overview
This page contains the initialization values for the registers of the peripheral(s) configured
by the component. 
<table>
<tr><td colspan="4" class="ttitle1">ASerialLdd1 Initialization</td></tr>
<tr><td class="ttitle2">Address</td><td class="ttitle2">Register</td><td class="ttitle2">Register Value</td><td class="ttitle2">Register Description</td></tr>
<tr><td>0x40048034</td><td>SIM_SCGC4</td>
<td class="regNotResetVal">0xF0100470</td>
 <td>SIM_SCGC4 register, peripheral ASerialLdd1.</td></tr>
<tr><td>0x4004A040</td><td>PORTB_PCR16</td>
<td class="regNotResetVal">0x00000300</td>
 <td>PORTB_PCR16 register, peripheral ASerialLdd1.</td></tr>
<tr><td>0x4004A044</td><td>PORTB_PCR17</td>
<td class="regNotResetVal">0x00000300</td>
 <td>PORTB_PCR17 register, peripheral ASerialLdd1.</td></tr>
<tr><td>0xE000E410</td><td>NVICIP16</td>
<td class="regNotResetVal">0x000000F0</td>
 <td>NVICIP16 register, peripheral ASerialLdd1.</td></tr>
<tr><td>0xE000E100</td><td>NVICISER0</td>
<td class="regNotResetVal">0x00030000</td>
 <td>NVICISER0 register, peripheral ASerialLdd1.</td></tr>
<tr><td>0xE000E411</td><td>NVICIP17</td>
<td class="regNotResetVal">0x00000080</td>
 <td>NVICIP17 register, peripheral ASerialLdd1.</td></tr>
<tr><td>0x4006A002</td><td>UART0_C1</td>
<td class="regResetVal">0x00000000</td>
 <td>UART0_C1 register, peripheral ASerialLdd1.</td></tr>
<tr><td>0x4006A006</td><td>UART0_C3</td>
<td class="regResetVal">0x00000000</td>
 <td>UART0_C3 register, peripheral ASerialLdd1.</td></tr>
<tr><td>0x4006A00A</td><td>UART0_C4</td>
<td class="regResetVal">0x00000000</td>
 <td>UART0_C4 register, peripheral ASerialLdd1.</td></tr>
<tr><td>0x4006A005</td><td>UART0_S2</td>
<td class="regResetVal">0x00000000</td>
 <td>UART0_S2 register, peripheral ASerialLdd1.</td></tr>
<tr><td>0x4006A00D</td><td>UART0_MODEM</td>
<td class="regResetVal">0x00000000</td>
 <td>UART0_MODEM register, peripheral ASerialLdd1.</td></tr>
</table>
Color Denotes Reset Value
<br/>
\page ASerialLdd1_regs_details Register Initialization Details
This page contains detailed description of initialization values for the 
registers of the peripheral(s) configured by the component. 

<div class="reghdr1">SIM_SCGC4</div>
<div class="regdiag">
<table class="regtbl">
<tr class="trd1r">
<td class="trd1c">Bit</td><td>31</td><td>30</td><td>29</td><td>28</td><td>27</td><td>26</td><td>25</td><td>24</td><td>23</td>
<td>22</td><td>21</td><td>20</td><td>19</td><td>18</td><td>17</td><td>16</td>
</tr>
<tr>
<td class="trd1c">R</td><td colspan="1" rowspan="2">-</td><td colspan="1" rowspan="2">-</td><td colspan="1" rowspan="2">-</td>
<td colspan="1" rowspan="2">-</td><td colspan="1" rowspan="2">-</td><td colspan="1" rowspan="2">-</td>
<td colspan="1" rowspan="2">-</td><td colspan="1" rowspan="2">-</td><td colspan="1" rowspan="2">-</td>
<td colspan="1" rowspan="2">-</td><td colspan="1" rowspan="2">-</td><td colspan="1" rowspan="2">VREF</td>
<td colspan="1" rowspan="2">CMP</td><td colspan="1" rowspan="2">USBOTG</td><td colspan="1" rowspan="2">-</td>
<td colspan="1" rowspan="2">-</td>
</tr>
<tr>
<td class="trd1c">W</td>
</tr>
<tr class="trd1r">
<td class="trd1c">Reset</td><td>1</td><td>1</td><td>1</td><td>1</td><td>0</td><td>0</td><td>0</td><td>0</td><td>0</td><td>0</td>
<td>0</td><td>1</td><td>0</td><td>0</td><td>0</td><td>0</td>
</tr>
</table>
<table class="regtbl">
<tr class="trd1r">
<td class="trd1c">Bit</td><td>15</td><td>14</td><td>13</td><td>12</td><td>11</td><td>10</td><td>9</td><td>8</td><td>7</td>
<td>6</td><td>5</td><td>4</td><td>3</td><td>2</td><td>1</td><td>0</td>
</tr>
<tr>
<td class="trd1c">R</td><td colspan="1" rowspan="2">-</td><td colspan="1" rowspan="2">-</td><td colspan="1" rowspan="2">-</td>
<td colspan="1" rowspan="2">UART2</td><td colspan="1" rowspan="2">UART1</td><td colspan="1" rowspan="2">UART0</td>
<td colspan="1" rowspan="2">-</td><td colspan="1" rowspan="2">-</td><td colspan="1" rowspan="2">-</td>
<td colspan="1" rowspan="2">I2C0</td><td colspan="1" rowspan="2">-</td><td colspan="1" rowspan="2">-</td>
<td colspan="1" rowspan="2">-</td><td colspan="1" rowspan="2">CMT</td><td colspan="1" rowspan="2">EWM</td>
<td colspan="1" rowspan="2">-</td>
</tr>
<tr>
<td class="trd1c">W</td>
</tr>
<tr class="trd1r">
<td class="trd1c">Reset</td><td>0</td><td>0</td><td>0</td><td>0</td><td>0</td><td>0</td><td>0</td><td>0</td><td>0</td><td>0</td>
<td>1</td><td>1</td><td>0</td><td>0</td><td>0</td><td>0</td>
</tr>
</table>
        
</div>
<table class="regtbl2"><tr><td class="trowtit" colspan="2">Address</td><td colspan="2">0x40048034</td></tr>
<tr class="trowtit"><td  class="trowtit" colspan="2">Initial value</td><td colspan="2">0xF0100470</td></tr>
<tr class="trowtit"><td  class="trowtit" colspan="2">After-reset value</td><td colspan="2">0xF0100030</td></tr>
<tr><td class="ttitle2">Bit</td><td class="ttitle2">Field</td><td class="ttitle2">Value</td><td class="ttitle2">Description</td></tr>
<tr><td>20</td><td>VREF</td><td>0x01</td><td>VREF Clock Gate Control</td>
<tr><td>19</td><td>CMP</td><td>0x00</td><td>Comparator Clock Gate Control</td>
<tr><td>18</td><td>USBOTG</td><td>0x00</td><td>USB Clock Gate Control</td>
<tr><td>12</td><td>UART2</td><td>0x00</td><td>UART2 Clock Gate Control</td>
<tr><td>11</td><td>UART1</td><td>0x00</td><td>UART1 Clock Gate Control</td>
<tr><td>10</td><td>UART0</td><td>0x01</td><td>UART0 Clock Gate Control</td>
<tr><td>6</td><td>I2C0</td><td>0x01</td><td>I2C0 Clock Gate Control</td>
<tr><td>2</td><td>CMT</td><td>0x00</td><td>CMT Clock Gate Control</td>
<tr><td>1</td><td>EWM</td><td>0x00</td><td>EWM Clock Gate Control</td>
</tr></table>
<div class="reghdr1">PORTB_PCR16</div>
<div class="regdiag">
<table class="regtbl">
<tr class="trd1r">
<td class="trd1c">Bit</td><td>31</td><td>30</td><td>29</td><td>28</td><td>27</td><td>26</td><td>25</td><td>24</td><td>23</td>
<td>22</td><td>21</td><td>20</td><td>19</td><td>18</td><td>17</td><td>16</td>
</tr>
<tr>
<td class="trd1c">R</td><td colspan="1" rowspan="2">-</td><td colspan="1" rowspan="2">-</td><td colspan="1" rowspan="2">-</td>
<td colspan="1" rowspan="2">-</td><td colspan="1" rowspan="2">-</td><td colspan="1" rowspan="2">-</td>
<td colspan="1" rowspan="2">-</td><td colspan="1" rowspan="2">ISF</td><td colspan="1" rowspan="2">-</td>
<td colspan="1" rowspan="2">-</td><td colspan="1" rowspan="2">-</td><td colspan="1" rowspan="2">-</td>
<td colspan="4" rowspan="2">IRQC</td>
</tr>
<tr>
<td class="trd1c">W</td>
</tr>
<tr class="trd1r">
<td class="trd1c">Reset</td><td>0</td><td>0</td><td>0</td><td>0</td><td>0</td><td>0</td><td>0</td><td>0</td><td>0</td><td>0</td>
<td>0</td><td>0</td><td>0</td><td>0</td><td>0</td><td>0</td>
</tr>
</table>
<table class="regtbl">
<tr class="trd1r">
<td class="trd1c">Bit</td><td>15</td><td>14</td><td>13</td><td>12</td><td>11</td><td>10</td><td>9</td><td>8</td><td>7</td>
<td>6</td><td>5</td><td>4</td><td>3</td><td>2</td><td>1</td><td>0</td>
</tr>
<tr>
<td class="trd1c">R</td><td colspan="1" rowspan="2">LK</td><td colspan="1" rowspan="2">-</td><td colspan="1" rowspan="2">-</td>
<td colspan="1" rowspan="2">-</td><td colspan="1" rowspan="2">-</td><td colspan="3" rowspan="2">MUX</td>
<td colspan="1" rowspan="2">-</td><td colspan="1" rowspan="2">DSE</td><td colspan="1" rowspan="2">ODE</td>
<td colspan="1" rowspan="2">PFE</td><td colspan="1" rowspan="2">-</td><td colspan="1" rowspan="2">SRE</td>
<td colspan="1" rowspan="2">PE</td><td colspan="1" rowspan="2">PS</td>
</tr>
<tr>
<td class="trd1c">W</td>
</tr>
<tr class="trd1r">
<td class="trd1c">Reset</td><td>0</td><td>0</td><td>0</td><td>0</td><td>0</td><td>0</td><td>0</td><td>0</td><td>0</td><td>0</td>
<td>0</td><td>0</td><td>0</td><td>0</td><td>0</td><td>0</td>
</tr>
</table>
        
</div>
<table class="regtbl2"><tr><td class="trowtit" colspan="2">Address</td><td colspan="2">0x4004A040</td></tr>
<tr class="trowtit"><td  class="trowtit" colspan="2">Initial value</td><td colspan="2">0x00000300</td></tr>
<tr class="trowtit"><td  class="trowtit" colspan="2">After-reset value</td><td colspan="2">0x00000000</td></tr>
<tr><td class="ttitle2">Bit</td><td class="ttitle2">Field</td><td class="ttitle2">Value</td><td class="ttitle2">Description</td></tr>
<tr><td>24</td><td>ISF</td><td>0x00</td><td>Interrupt Status Flag</td>
<tr><td>16 - 19</td><td>IRQC</td><td>0x00</td><td>Interrupt Configuration</td>
<tr><td>15</td><td>LK</td><td>0x00</td><td>Lock Register</td>
<tr><td>8 - 10</td><td>MUX</td><td>0x00</td><td>Pin Mux Control</td>
<tr><td>6</td><td>DSE</td><td>0x00</td><td>Drive Strength Enable</td>
<tr><td>5</td><td>ODE</td><td>0x00</td><td>Open Drain Enable</td>
<tr><td>4</td><td>PFE</td><td>0x00</td><td>Passive Filter Enable</td>
<tr><td>2</td><td>SRE</td><td>0x00</td><td>Slew Rate Enable</td>
<tr><td>1</td><td>PE</td><td>0x00</td><td>Pull Enable</td>
<tr><td>0</td><td>PS</td><td>0x00</td><td>Pull Select</td>
</tr></table>
<div class="reghdr1">PORTB_PCR17</div>
<div class="regdiag">
<table class="regtbl">
<tr class="trd1r">
<td class="trd1c">Bit</td><td>31</td><td>30</td><td>29</td><td>28</td><td>27</td><td>26</td><td>25</td><td>24</td><td>23</td>
<td>22</td><td>21</td><td>20</td><td>19</td><td>18</td><td>17</td><td>16</td>
</tr>
<tr>
<td class="trd1c">R</td><td colspan="1" rowspan="2">-</td><td colspan="1" rowspan="2">-</td><td colspan="1" rowspan="2">-</td>
<td colspan="1" rowspan="2">-</td><td colspan="1" rowspan="2">-</td><td colspan="1" rowspan="2">-</td>
<td colspan="1" rowspan="2">-</td><td colspan="1" rowspan="2">ISF</td><td colspan="1" rowspan="2">-</td>
<td colspan="1" rowspan="2">-</td><td colspan="1" rowspan="2">-</td><td colspan="1" rowspan="2">-</td>
<td colspan="4" rowspan="2">IRQC</td>
</tr>
<tr>
<td class="trd1c">W</td>
</tr>
<tr class="trd1r">
<td class="trd1c">Reset</td><td>0</td><td>0</td><td>0</td><td>0</td><td>0</td><td>0</td><td>0</td><td>0</td><td>0</td><td>0</td>
<td>0</td><td>0</td><td>0</td><td>0</td><td>0</td><td>0</td>
</tr>
</table>
<table class="regtbl">
<tr class="trd1r">
<td class="trd1c">Bit</td><td>15</td><td>14</td><td>13</td><td>12</td><td>11</td><td>10</td><td>9</td><td>8</td><td>7</td>
<td>6</td><td>5</td><td>4</td><td>3</td><td>2</td><td>1</td><td>0</td>
</tr>
<tr>
<td class="trd1c">R</td><td colspan="1" rowspan="2">LK</td><td colspan="1" rowspan="2">-</td><td colspan="1" rowspan="2">-</td>
<td colspan="1" rowspan="2">-</td><td colspan="1" rowspan="2">-</td><td colspan="3" rowspan="2">MUX</td>
<td colspan="1" rowspan="2">-</td><td colspan="1" rowspan="2">DSE</td><td colspan="1" rowspan="2">ODE</td>
<td colspan="1" rowspan="2">PFE</td><td colspan="1" rowspan="2">-</td><td colspan="1" rowspan="2">SRE</td>
<td colspan="1" rowspan="2">PE</td><td colspan="1" rowspan="2">PS</td>
</tr>
<tr>
<td class="trd1c">W</td>
</tr>
<tr class="trd1r">
<td class="trd1c">Reset</td><td>0</td><td>0</td><td>0</td><td>0</td><td>0</td><td>0</td><td>0</td><td>0</td><td>0</td><td>0</td>
<td>0</td><td>0</td><td>0</td><td>0</td><td>0</td><td>0</td>
</tr>
</table>
        
</div>
<table class="regtbl2"><tr><td class="trowtit" colspan="2">Address</td><td colspan="2">0x4004A044</td></tr>
<tr class="trowtit"><td  class="trowtit" colspan="2">Initial value</td><td colspan="2">0x00000300</td></tr>
<tr class="trowtit"><td  class="trowtit" colspan="2">After-reset value</td><td colspan="2">0x00000000</td></tr>
<tr><td class="ttitle2">Bit</td><td class="ttitle2">Field</td><td class="ttitle2">Value</td><td class="ttitle2">Description</td></tr>
<tr><td>24</td><td>ISF</td><td>0x00</td><td>Interrupt Status Flag</td>
<tr><td>16 - 19</td><td>IRQC</td><td>0x00</td><td>Interrupt Configuration</td>
<tr><td>15</td><td>LK</td><td>0x00</td><td>Lock Register</td>
<tr><td>8 - 10</td><td>MUX</td><td>0x00</td><td>Pin Mux Control</td>
<tr><td>6</td><td>DSE</td><td>0x00</td><td>Drive Strength Enable</td>
<tr><td>5</td><td>ODE</td><td>0x00</td><td>Open Drain Enable</td>
<tr><td>4</td><td>PFE</td><td>0x00</td><td>Passive Filter Enable</td>
<tr><td>2</td><td>SRE</td><td>0x00</td><td>Slew Rate Enable</td>
<tr><td>1</td><td>PE</td><td>0x00</td><td>Pull Enable</td>
<tr><td>0</td><td>PS</td><td>0x00</td><td>Pull Select</td>
</tr></table>
<div class="reghdr1">NVICIP16</div>
<div class="regdiag">
<table class="regtbl">
<tr class="trd1r">
<td class="trd1c">Bit</td><td>7</td><td>6</td><td>5</td><td>4</td><td>3</td><td>2</td><td>1</td><td>0</td>
</tr>
<tr>
<td class="trd1c">R</td><td colspan="8" rowspan="2">PRI16</td>
</tr>
<tr>
<td class="trd1c">W</td>
</tr>
<tr class="trd1r">
<td class="trd1c">Reset</td><td>0</td><td>0</td><td>0</td><td>0</td><td>0</td><td>0</td><td>0</td><td>0</td>
</tr>
</table>
        
</div>
<table class="regtbl2"><tr><td class="trowtit" colspan="2">Address</td><td colspan="2">0xE000E410</td></tr>
<tr class="trowtit"><td  class="trowtit" colspan="2">Initial value</td><td colspan="2">0x000000F0</td></tr>
<tr class="trowtit"><td  class="trowtit" colspan="2">After-reset value</td><td colspan="2">0x00000000</td></tr>
<tr><td class="ttitle2">Bit</td><td class="ttitle2">Field</td><td class="ttitle2">Value</td><td class="ttitle2">Description</td></tr>
<tr><td>0 - 7</td><td>PRI16</td><td>0x80</td><td>Priority of interrupt 16</td>
</tr></table>
<div class="reghdr1">NVICISER0</div>
<div class="regdiag">
<table class="regtbl">
<tr class="trd1r">
<td class="trd1c">Bit</td><td>31</td><td>30</td><td>29</td><td>28</td><td>27</td><td>26</td><td>25</td><td>24</td><td>23</td>
<td>22</td><td>21</td><td>20</td><td>19</td><td>18</td><td>17</td><td>16</td>
</tr>
<tr>
<td class="trd1c">R</td><td colspan="16" rowspan="2">SETENA</td>
</tr>
<tr>
<td class="trd1c">W</td>
</tr>
<tr class="trd1r">
<td class="trd1c">Reset</td><td>0</td><td>0</td><td>0</td><td>0</td><td>0</td><td>0</td><td>0</td><td>0</td><td>0</td><td>0</td>
<td>0</td><td>0</td><td>0</td><td>0</td><td>0</td><td>0</td>
</tr>
</table>
<table class="regtbl">
<tr class="trd1r">
<td class="trd1c">Bit</td><td>15</td><td>14</td><td>13</td><td>12</td><td>11</td><td>10</td><td>9</td><td>8</td><td>7</td>
<td>6</td><td>5</td><td>4</td><td>3</td><td>2</td><td>1</td><td>0</td>
</tr>
<tr>
<td class="trd1c">R</td><td colspan="32" rowspan="2">SETENA</td>
</tr>
<tr>
<td class="trd1c">W</td>
</tr>
<tr class="trd1r">
<td class="trd1c">Reset</td><td>0</td><td>0</td><td>0</td><td>0</td><td>0</td><td>0</td><td>0</td><td>0</td><td>0</td><td>0</td>
<td>0</td><td>0</td><td>0</td><td>0</td><td>0</td><td>0</td>
</tr>
</table>
        
</div>
<table class="regtbl2"><tr><td class="trowtit" colspan="2">Address</td><td colspan="2">0xE000E100</td></tr>
<tr class="trowtit"><td  class="trowtit" colspan="2">Initial value</td><td colspan="2">0x00030000</td></tr>
<tr class="trowtit"><td  class="trowtit" colspan="2">After-reset value</td><td colspan="2">0x00000000</td></tr>
<tr><td class="ttitle2">Bit</td><td class="ttitle2">Field</td><td class="ttitle2">Value</td><td class="ttitle2">Description</td></tr>
<tr><td>0 - 31</td><td>SETENA</td><td>0x00</td><td>Interrupt set enable bits</td>
</tr></table>
<div class="reghdr1">NVICIP17</div>
<div class="regdiag">
<table class="regtbl">
<tr class="trd1r">
<td class="trd1c">Bit</td><td>7</td><td>6</td><td>5</td><td>4</td><td>3</td><td>2</td><td>1</td><td>0</td>
</tr>
<tr>
<td class="trd1c">R</td><td colspan="8" rowspan="2">PRI17</td>
</tr>
<tr>
<td class="trd1c">W</td>
</tr>
<tr class="trd1r">
<td class="trd1c">Reset</td><td>0</td><td>0</td><td>0</td><td>0</td><td>0</td><td>0</td><td>0</td><td>0</td>
</tr>
</table>
        
</div>
<table class="regtbl2"><tr><td class="trowtit" colspan="2">Address</td><td colspan="2">0xE000E411</td></tr>
<tr class="trowtit"><td  class="trowtit" colspan="2">Initial value</td><td colspan="2">0x00000080</td></tr>
<tr class="trowtit"><td  class="trowtit" colspan="2">After-reset value</td><td colspan="2">0x00000000</td></tr>
<tr><td class="ttitle2">Bit</td><td class="ttitle2">Field</td><td class="ttitle2">Value</td><td class="ttitle2">Description</td></tr>
<tr><td>0 - 7</td><td>PRI17</td><td>0x80</td><td>Priority of interrupt 17</td>
</tr></table>
<div class="reghdr1">UART0_C1</div>
<div class="regdiag">
<table class="regtbl">
<tr class="trd1r">
<td class="trd1c">Bit</td><td>7</td><td>6</td><td>5</td><td>4</td><td>3</td><td>2</td><td>1</td><td>0</td>
</tr>
<tr>
<td class="trd1c">R</td><td colspan="1" rowspan="2">LOOPS</td><td colspan="1" rowspan="2">UARTSWAI</td>
<td colspan="1" rowspan="2">RSRC</td><td colspan="1" rowspan="2">M</td><td colspan="1" rowspan="2">WAKE</td>
<td colspan="1" rowspan="2">ILT</td><td colspan="1" rowspan="2">PE</td><td colspan="1" rowspan="2">PT</td>
</tr>
<tr>
<td class="trd1c">W</td>
</tr>
<tr class="trd1r">
<td class="trd1c">Reset</td><td>0</td><td>0</td><td>0</td><td>0</td><td>0</td><td>0</td><td>0</td><td>0</td>
</tr>
</table>
        
</div>
<table class="regtbl2"><tr><td class="trowtit" colspan="2">Address</td><td colspan="2">0x4006A002</td></tr>
<tr class="trowtit"><td  class="trowtit" colspan="2">Initial value</td><td colspan="2">0x00000000</td></tr>
<tr class="trowtit"><td  class="trowtit" colspan="2">After-reset value</td><td colspan="2">0x00000000</td></tr>
<tr><td class="ttitle2">Bit</td><td class="ttitle2">Field</td><td class="ttitle2">Value</td><td class="ttitle2">Description</td></tr>
<tr><td>7</td><td>LOOPS</td><td>0x00</td><td>Loop Mode Select</td>
<tr><td>6</td><td>UARTSWAI</td><td>0x00</td><td>UART Stops in Wait Mode</td>
<tr><td>5</td><td>RSRC</td><td>0x00</td><td>Receiver Source Select</td>
<tr><td>4</td><td>M</td><td>0x00</td><td>9-bit or 8-bit Mode Select</td>
<tr><td>3</td><td>WAKE</td><td>0x00</td><td>Receiver Wakeup Method Select</td>
<tr><td>2</td><td>ILT</td><td>0x00</td><td>Idle Line Type Select</td>
<tr><td>1</td><td>PE</td><td>0x00</td><td>Parity Enable</td>
<tr><td>0</td><td>PT</td><td>0x00</td><td>Parity Type</td>
</tr></table>
<div class="reghdr1">UART0_C3</div>
<div class="regdiag">
<table class="regtbl">
<tr class="trd1r">
<td class="trd1c">Bit</td><td>7</td><td>6</td><td>5</td><td>4</td><td>3</td><td>2</td><td>1</td><td>0</td>
</tr>
<tr>
<td class="trd1c">R</td><td colspan="1" rowspan="1">R8</td><td colspan="1" rowspan="2">T8</td>
<td colspan="1" rowspan="2">TXDIR</td><td colspan="1" rowspan="2">TXINV</td><td colspan="1" rowspan="2">ORIE</td>
<td colspan="1" rowspan="2">NEIE</td><td colspan="1" rowspan="2">FEIE</td><td colspan="1" rowspan="2">PEIE</td>
</tr>
<tr>
<td class="trd1c">W</td>
<td colspan="1"></td>
</tr>
<tr class="trd1r">
<td class="trd1c">Reset</td><td>0</td><td>0</td><td>0</td><td>0</td><td>0</td><td>0</td><td>0</td><td>0</td>
</tr>
</table>
        
</div>
<table class="regtbl2"><tr><td class="trowtit" colspan="2">Address</td><td colspan="2">0x4006A006</td></tr>
<tr class="trowtit"><td  class="trowtit" colspan="2">Initial value</td><td colspan="2">0x00000000</td></tr>
<tr class="trowtit"><td  class="trowtit" colspan="2">After-reset value</td><td colspan="2">0x00000000</td></tr>
<tr><td class="ttitle2">Bit</td><td class="ttitle2">Field</td><td class="ttitle2">Value</td><td class="ttitle2">Description</td></tr>
<tr><td>7</td><td>R8</td><td>0x00</td><td>Received Bit 8</td>
<tr><td>6</td><td>T8</td><td>0x00</td><td>Transmit Bit 8</td>
<tr><td>5</td><td>TXDIR</td><td>0x00</td><td>Transmitter Pin Data Direction in Single-Wire mode</td>
<tr><td>4</td><td>TXINV</td><td>0x00</td><td>Transmit Data Inversion</td>
<tr><td>3</td><td>ORIE</td><td>0x00</td><td>Overrun Error Interrupt Enable</td>
<tr><td>2</td><td>NEIE</td><td>0x00</td><td>Noise Error Interrupt Enable</td>
<tr><td>1</td><td>FEIE</td><td>0x00</td><td>Framing Error Interrupt Enable</td>
<tr><td>0</td><td>PEIE</td><td>0x00</td><td>Parity Error Interrupt Enable</td>
</tr></table>
<div class="reghdr1">UART0_C4</div>
<div class="regdiag">
<table class="regtbl">
<tr class="trd1r">
<td class="trd1c">Bit</td><td>7</td><td>6</td><td>5</td><td>4</td><td>3</td><td>2</td><td>1</td><td>0</td>
</tr>
<tr>
<td class="trd1c">R</td><td colspan="1" rowspan="2">MAEN1</td><td colspan="1" rowspan="2">MAEN2</td>
<td colspan="1" rowspan="2">M10</td><td colspan="5" rowspan="2">BRFA</td>
</tr>
<tr>
<td class="trd1c">W</td>
</tr>
<tr class="trd1r">
<td class="trd1c">Reset</td><td>0</td><td>0</td><td>0</td><td>0</td><td>0</td><td>0</td><td>0</td><td>0</td>
</tr>
</table>
        
</div>
<table class="regtbl2"><tr><td class="trowtit" colspan="2">Address</td><td colspan="2">0x4006A00A</td></tr>
<tr class="trowtit"><td  class="trowtit" colspan="2">Initial value</td><td colspan="2">0x00000000</td></tr>
<tr class="trowtit"><td  class="trowtit" colspan="2">After-reset value</td><td colspan="2">0x00000000</td></tr>
<tr><td class="ttitle2">Bit</td><td class="ttitle2">Field</td><td class="ttitle2">Value</td><td class="ttitle2">Description</td></tr>
<tr><td>7</td><td>MAEN1</td><td>0x00</td><td>Match Address Mode Enable 1</td>
<tr><td>6</td><td>MAEN2</td><td>0x00</td><td>Match Address Mode Enable 2</td>
<tr><td>5</td><td>M10</td><td>0x00</td><td>10-bit Mode select</td>
<tr><td>0 - 4</td><td>BRFA</td><td>0x00</td><td>Baud Rate Fine Adjust</td>
</tr></table>
<div class="reghdr1">UART0_S2</div>
<div class="regdiag">
<table class="regtbl">
<tr class="trd1r">
<td class="trd1c">Bit</td><td>7</td><td>6</td><td>5</td><td>4</td><td>3</td><td>2</td><td>1</td><td>0</td>
</tr>
<tr>
<td class="trd1c">R</td><td colspan="1" rowspan="2">LBKDIF</td><td colspan="1" rowspan="2">RXEDGIF</td>
<td colspan="1" rowspan="2">MSBF</td><td colspan="1" rowspan="2">RXINV</td><td colspan="1" rowspan="2">RWUID</td>
<td colspan="1" rowspan="2">BRK13</td><td colspan="1" rowspan="2">LBKDE</td><td colspan="1" rowspan="1">RAF</td>
</tr>
<tr>
<td class="trd1c">W</td>
<td colspan="1"></td>
</tr>
<tr class="trd1r">
<td class="trd1c">Reset</td><td>0</td><td>0</td><td>0</td><td>0</td><td>0</td><td>0</td><td>0</td><td>0</td>
</tr>
</table>
        
</div>
<table class="regtbl2"><tr><td class="trowtit" colspan="2">Address</td><td colspan="2">0x4006A005</td></tr>
<tr class="trowtit"><td  class="trowtit" colspan="2">Initial value</td><td colspan="2">0x00000000</td></tr>
<tr class="trowtit"><td  class="trowtit" colspan="2">After-reset value</td><td colspan="2">0x00000000</td></tr>
<tr><td class="ttitle2">Bit</td><td class="ttitle2">Field</td><td class="ttitle2">Value</td><td class="ttitle2">Description</td></tr>
<tr><td>7</td><td>LBKDIF</td><td>0x00</td><td>LIN Break Detect Interrupt Flag</td>
<tr><td>6</td><td>RXEDGIF</td><td>0x00</td><td>RxD Pin Active Edge Interrupt Flag</td>
<tr><td>5</td><td>MSBF</td><td>0x00</td><td>Most Significant Bit First</td>
<tr><td>4</td><td>RXINV</td><td>0x00</td><td>Receive Data Inversion</td>
<tr><td>3</td><td>RWUID</td><td>0x00</td><td>Receive Wakeup Idle Detect</td>
<tr><td>2</td><td>BRK13</td><td>0x00</td><td>Break Transmit Character Length</td>
<tr><td>1</td><td>LBKDE</td><td>0x00</td><td>LIN Break Detection Enable</td>
<tr><td>0</td><td>RAF</td><td>0x00</td><td>Receiver Active Flag</td>
</tr></table>
<div class="reghdr1">UART0_MODEM</div>
<div class="regdiag">
<table class="regtbl">
<tr class="trd1r">
<td class="trd1c">Bit</td><td>7</td><td>6</td><td>5</td><td>4</td><td>3</td><td>2</td><td>1</td><td>0</td>
</tr>
<tr>
<td class="trd1c">R</td><td colspan="1" rowspan="2">-</td><td colspan="1" rowspan="2">-</td><td colspan="1" rowspan="2">-</td>
<td colspan="1" rowspan="2">-</td><td colspan="1" rowspan="2">RXRTSE</td><td colspan="1" rowspan="2">TXRTSPOL</td>
<td colspan="1" rowspan="2">TXRTSE</td><td colspan="1" rowspan="2">TXCTSE</td>
</tr>
<tr>
<td class="trd1c">W</td>
</tr>
<tr class="trd1r">
<td class="trd1c">Reset</td><td>0</td><td>0</td><td>0</td><td>0</td><td>0</td><td>0</td><td>0</td><td>0</td>
</tr>
</table>
        
</div>
<table class="regtbl2"><tr><td class="trowtit" colspan="2">Address</td><td colspan="2">0x4006A00D</td></tr>
<tr class="trowtit"><td  class="trowtit" colspan="2">Initial value</td><td colspan="2">0x00000000</td></tr>
<tr class="trowtit"><td  class="trowtit" colspan="2">After-reset value</td><td colspan="2">0x00000000</td></tr>
<tr><td class="ttitle2">Bit</td><td class="ttitle2">Field</td><td class="ttitle2">Value</td><td class="ttitle2">Description</td></tr>
<tr><td>3</td><td>RXRTSE</td><td>0x00</td><td>Receiver request-to-send enable</td>
<tr><td>2</td><td>TXRTSPOL</td><td>0x00</td><td>Transmitter request-to-send polarity</td>
<tr><td>1</td><td>TXRTSE</td><td>0x00</td><td>Transmitter request-to-send enable</td>
<tr><td>0</td><td>TXCTSE</td><td>0x00</td><td>Transmitter clear-to-send enable</td>
</tr></table>
*/
/*!
\page ASerialLdd1_settings Component Settings
\code
**          Component name                                 : ASerialLdd1
**          Device                                         : UART0
**          Interrupt service/event                        : Enabled
**            Interrupt RxD                                : INT_UART0_RX_TX
**            Interrupt RxD priority                       : 15
**            Interrupt TxD                                : INT_UART0_RX_TX
**            Interrupt TxD priority                       : 15
**            Interrupt Error                              : INT_UART0_ERR
**            Interrupt Error priority                     : medium priority
**          Settings                                       : 
**            Data width                                   : 8 bits
**            Parity                                       : None
**            Stop bits                                    : 1
**            Loop mode                                    : Normal
**            Baud rate                                    : 9600 baud
**            Wakeup condition                             : Idle line wakeup
**            Stop in wait mode                            : no
**            Idle line mode                               : Starts after start bit
**            Transmitter output                           : Not inverted
**            Receiver input                               : Not inverted
**            Break generation length                      : 10/11 bits
**            Receiver                                     : Enabled
**              RxD                                        : TSI0_CH9/PTB16/UART0_RX/EWM_IN
**              RxD pin signal                             : 
**            Transmitter                                  : Enabled
**              TxD                                        : TSI0_CH10/PTB17/UART0_TX/EWM_OUT_b
**              TxD pin signal                             : 
**            Flow control                                 : None
**          Initialization                                 : 
**            Enabled in init. code                        : yes
**            Auto initialization                          : no
**            Event mask                                   : 
**              OnBlockSent                                : Enabled
**              OnBlockReceived                            : Enabled
**              OnTxComplete                               : Disabled
**              OnError                                    : Enabled
**              OnBreak                                    : Enabled
**          CPU clock/configuration selection              : 
**            Clock configuration 0                        : This component enabled
**            Clock configuration 1                        : This component disabled
**            Clock configuration 2                        : This component disabled
**            Clock configuration 3                        : This component disabled
**            Clock configuration 4                        : This component disabled
**            Clock configuration 5                        : This component disabled
**            Clock configuration 6                        : This component disabled
**            Clock configuration 7                        : This component disabled
<h1>
\endcode
*/
