clintonelliott23/CT-Monitoring-Assignment/CTM - 3D Case/boxass.SLDASM

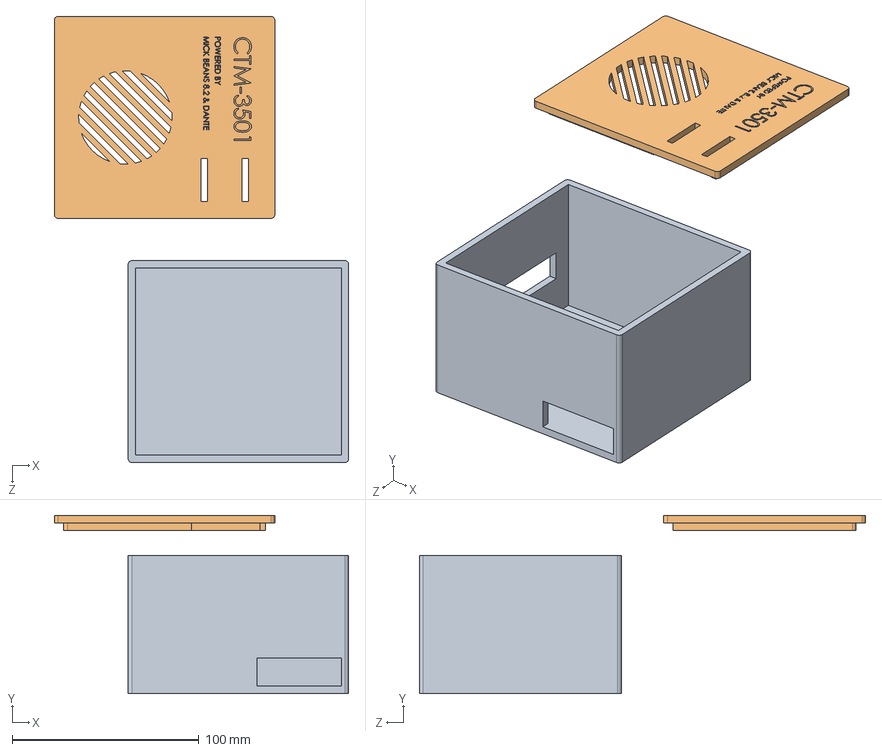
[picture p42: CAD file, 2017-10-29]
CTM - 3D Case/boxass.SLDASM
157.5 x 95.4 x 238.6 mm
lid
