clintonelliott23/CT-Monitoring-Assignment/CTM - 3D Case/lid.STEP

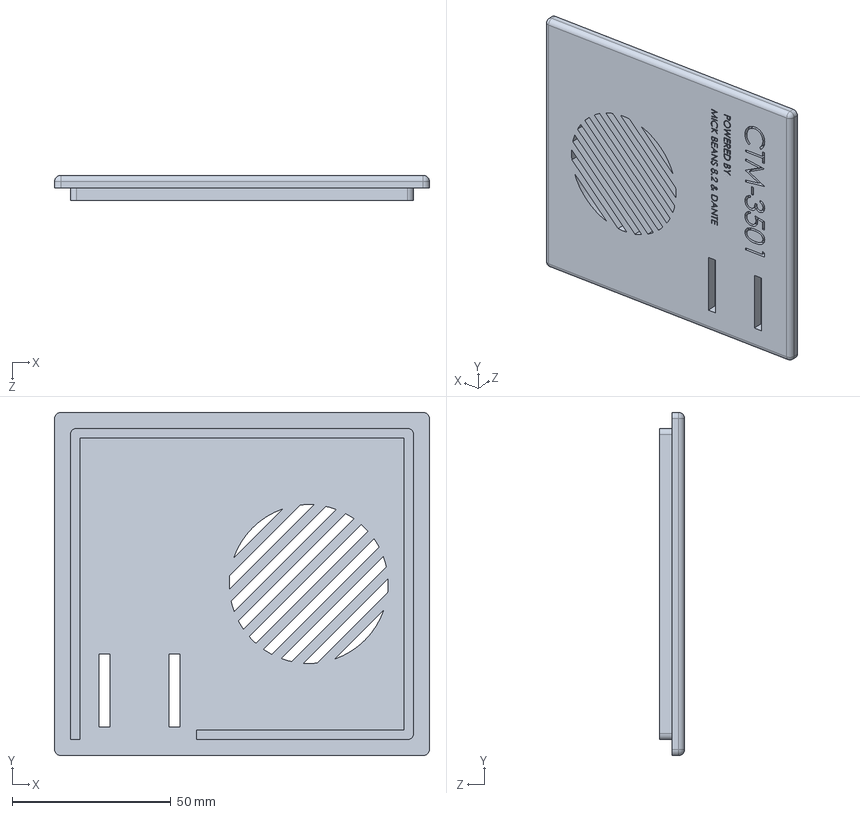
[picture p43: CAD file, 2017-10-29]
CTM - 3D Case/lid.STEP
118.0 x 108.0 x 8.00 mm
