clintonelliott23/CT-Monitoring-Assignment/CTM - 3D Case/box.STEP

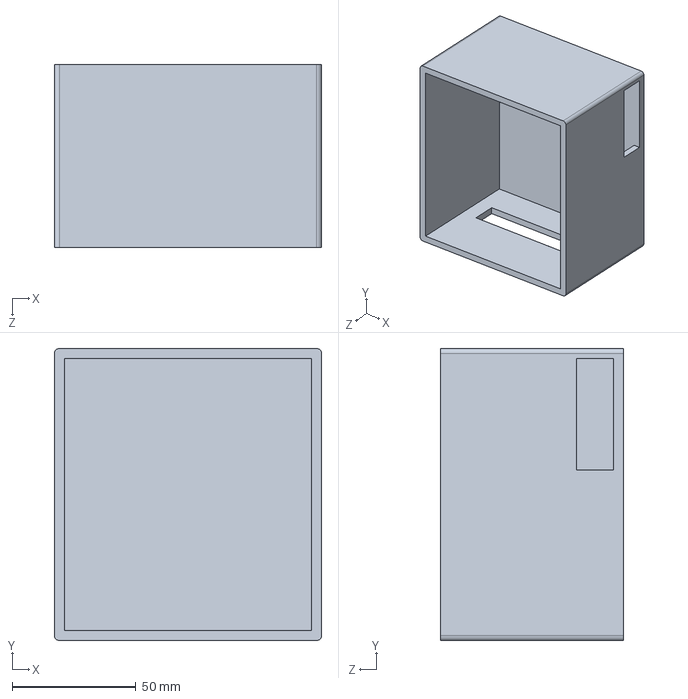
[picture p44: CAD file, 2017-10-29]
CTM - 3D Case/box.STEP
108.0 x 118.0 x 74.0 mm
