clintonelliott23/CT-Monitoring-Assignment/(list of files, cad)

Other CAD files:
CTM - 3D Case/lidorientated.STL
CTM - 3D Case/boxorientatedfinal.stl
CTM - 3D Case/boxorientated.STL
CTM - 3D Case/Clinton_Elliott_Box.stl
CTM - 3D Case/lidorientatedfinal.stl
CTM - 3D Case/Clinton_Elliott_Lid.stl
CTM - 3D Case/box.SLDPRT
CTM - 3D Case/box.STL
CTM - 3D Case/lid.SLDPRT
CTM - 3D Case/lid.STL
