clintonelliott23/CT-Monitoring-Assignment/CTM - Report & Manual/CT-Metering-Assignment-R_4.docx

CURRENT TRASFORMER METER CTM-3501 | Abstract This report contains the design, implementation, and testing of a non-invasive near to real-time current metering protocol for alternating systems. Michael Giorgas & Clinton Elliott Electrical Engineering BA (Electronic)

You had me at “Hello World”;

-Anonymous

# TABLE OF CONTENTS

(https://d.docs.live.net/c07c9239cf8ef362/2nd%20Year2/EE2300/Past%20Exams/EE2300%20-%20Assignment.docx)

# LIST OF FIGURES

CURRENT TRASFORMER METER

# 1. INTRODUCTION

The aim of this project was to design and implement the CTM-3501. This report outlines the design of the circuit with calculations and diagrams. The implementation in Code Warrior using Free Scale will be discussed and explained. The final product and testing will be evaluated, commented upon, and recommendations are given.

The CTM-3501 (CTM for short) stands for Current Transformer Meter and followed by the model number i.e. CTM-xxxx. The 35xx series are the top of the range on the market. The CTM was initially designed to meet the minimum requirements of having an embedded system with a sensor which acquires data. The features to be implemented were given flexible conditions, while the team behind the CTM were driven to achieve a glorious result.

A current transformer (CT) is and electrical device used to step or scale current down to a safe working current to be measured by meters and relay for protection and monitoring. The CT gives a proportional current in its secondary winding to the current in the primary winding based on the turns ratio, and should have approximately a negligible load. Owing to the construction of CTs, they provide electrical isolation from the high voltage circuit through the windings, consequently increasing safety. Generally, these transformers have a small number of primary turns and a larger number of secondary turns which defines the turns ratio [1]. Figure 1 shows a VT comprising of the primary and secondary windings, and earthed secondary winding.

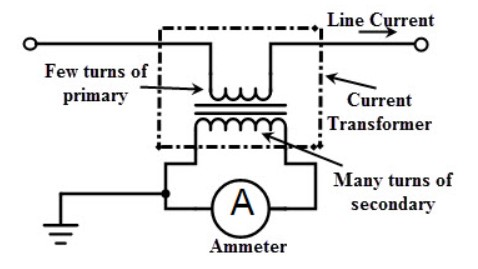
[picture p45: figure]

Figure 1 - Current Transformer [1]

There are several types of CTs including wound type, bar type and window type transformers. The CT behaves similar to a normal transformer in no load conditions (small burden) and therefore the secondary normally has low currents and is earthed for safety precautions. The current on the secondary winding is governed by the equation:

I_1 N_1 = I_2 N_2

Where I_1 is the primary winding current, I_2 is the secondary winding current, N_1 and N_2 are the number of turns for the primary and secondary windings respectively. If the secondary winding is not shorted (by a burden resistor) than high dangerous voltages can occur governed by equation:

V_2 =V_1 ( (N_2)/(N_1))

To demonstrate this effect, we assume a N_1 and N_2 are 1 and 100 with a primary voltage of 230. Substituting into the equation:

V_2 =230( 100/1)

=23,000 kV

Therefore, a CT with a turns ratio of 100:1 can develop 23 kV with nominal phase voltage. Most insulation is rated to 1000 V and this high voltage can degrade the insulation creating hazards. Current transformers are used in many aspects of a power system. They are utilized in power distribution, generating stations, substations and at domestic, commercial and industrial levels [1].

The essence of the design was to monitor an alternating current using a current transformer (CT). The CT’s were to be part of a sensor node which sent information via wireless communication to a base station. The base station was a Raspberry Pi which could forward near to real-time data upload to the internet. The complete design process of the CTM is explained in this document and a corresponding user manual is attached.

# 2. OVERVIEW OF DESIGN

The fundamental operation of the CTM is displayed in Figure 2 and depicts the start of the data acquisition from the current transformers. The voltage is shifted using the wave shaping and converted to a digital signal. This signal is then computed to get a desired output based on the calibration phase and type of current transformer being used. The data is then sent over radio frequency to a base station Raspberry Pi and uploaded via WiPi to ThingSpeak for webpage display.

Current Transformers
Wave Shaping
Raspberry Pi
Reception
Analogue-Digital Conversion
Calibrated Calculations
Zigbee RF Transmission
WiPi Upload
Internet
ThingSpeak Webpage Display

Figure 2 -Overview of Operation

# 3. HARDWARE DESIGN

## 3.1. Schematic

The CTM was based on the embedded system design of the Kinetis FRDM K20DX128M5 board for the processing circuit. The schematic was compartmentalized into several parts during the design process and each part is discussed as per its design in the following sections.

### 3.1.1. Power Supply

The two processors each required 3.3 V power supply, so during the design this was the primary reason for selecting 3.3 V. The power design is shown in Figure 3.

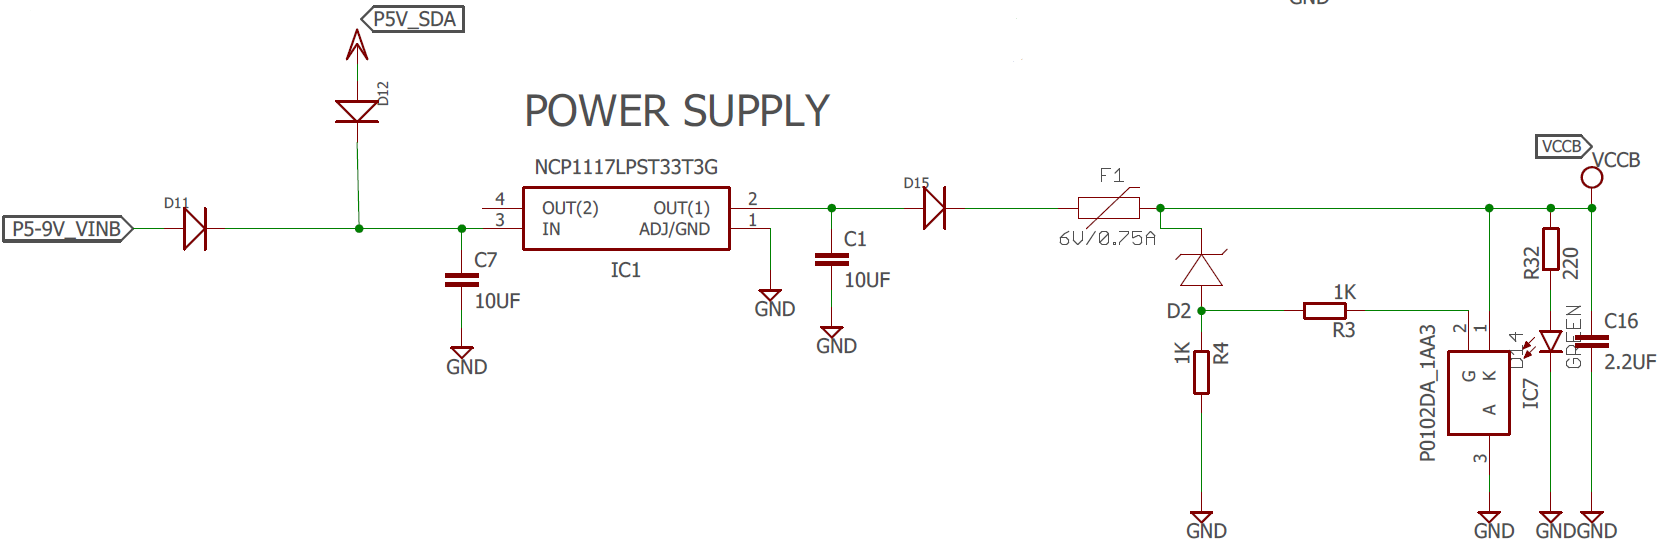
[picture p46: figure]

Figure 3 - Power Supply and Corresponding Protection

The supply to the circuit was from a 9 V coin-cell battery or from a 5 V USB with each passing through the diodes D11 and D12 to prevent incorrect connection. Each supply was fed into a power supply with the capacitor sizes selected from the data sheet for the NCP1117LPST33TCG. It was noted that at 3.3 V the regulator could output current in excess of 1.0A. The poly fuse F1 was selected at 0.75 A as this would protect the regulator and was above the calculated maximum current draw of the circuit (See Battery Sizing & Maximum Current). The SCR and D2 and resistor provide Crowbar protection in the event of voltage spikes. D2 was selected at 3.5 V to prevent transients entering the processors and causing damage. The poly fuse provides over-current protection and the crowbar protection provides over-voltage protection.

### 3.1.2. Operational Input Shifters

The CTs transduce the current into a voltage which is fed into the LM358 op-amp. The output voltage is level shifted from the input bias voltage on the non-inverting pin from the voltage division over the potentiometer VPOT as shown in Figure 4.


Figure 4 - Operational Amplifiers and Input Shifting Circuit

Figure 4 shows the output is clipped by the diode D7 which was set at 3.3 V. If the output voltage was above this value then it was clipped to earth protecting the input pins to the processor against transients. The original values for the POTs were calculated but it was found that each need to be adjusted due to manufacturer tolerances. The wave form need to be shifted positively half the maximum input voltage of 3.3 V. This meant 1.65 V input bias but this was affected during prototyping due to power supply voltages. Note the headers which were installed near the headphone jack for testing purposes.

### 3.1.3. Multiplexer

The multiplexer (MUX) was incorporated to reduce the power consumed by the op-amps and POTs. The MUX was supplied power by the microprocessor and switched between the op-amp circuits. This allowed the op-amp circuits to be only powered while data was being recorded. The MUX is shown in Figure 5 and the timing is shown in Figure 15.

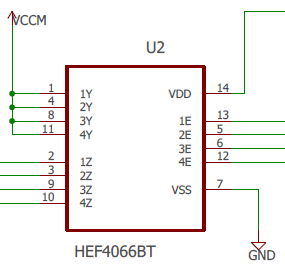
[picture p47: figure]

Figure 5 - Multiplexer

The MUX is powered during the cycle (see Figure 15) and switches between CT1, CT2, CT3 and CT4. This allows only one CT circuit to be powered at a time reducing the power consumed by four. The upshot of switching from the microprocessor is that the MUX is only power during the cycle which reduces the amount of power consumed by the MUX by 15.

### 3.1.4. ZigBee

The Xbee module brand a Zigbee compliant radios made by Digi International wwas chosen for the wireless communication due to its low power, low data rate which is ideal for battery applications. The Zigbee communication standard supports mesh networks and is used in applications with sensor networks which require machine-to-machine communications.

The transmitter used was the ZigBee. This was selected due to familiarity and the ability to place the device into sleep mode by switching the sleep pin from the microprocessor and is shown in Figure 6. This meant that only once a phase the ZigBee had to be powered which decreased the power consumption.

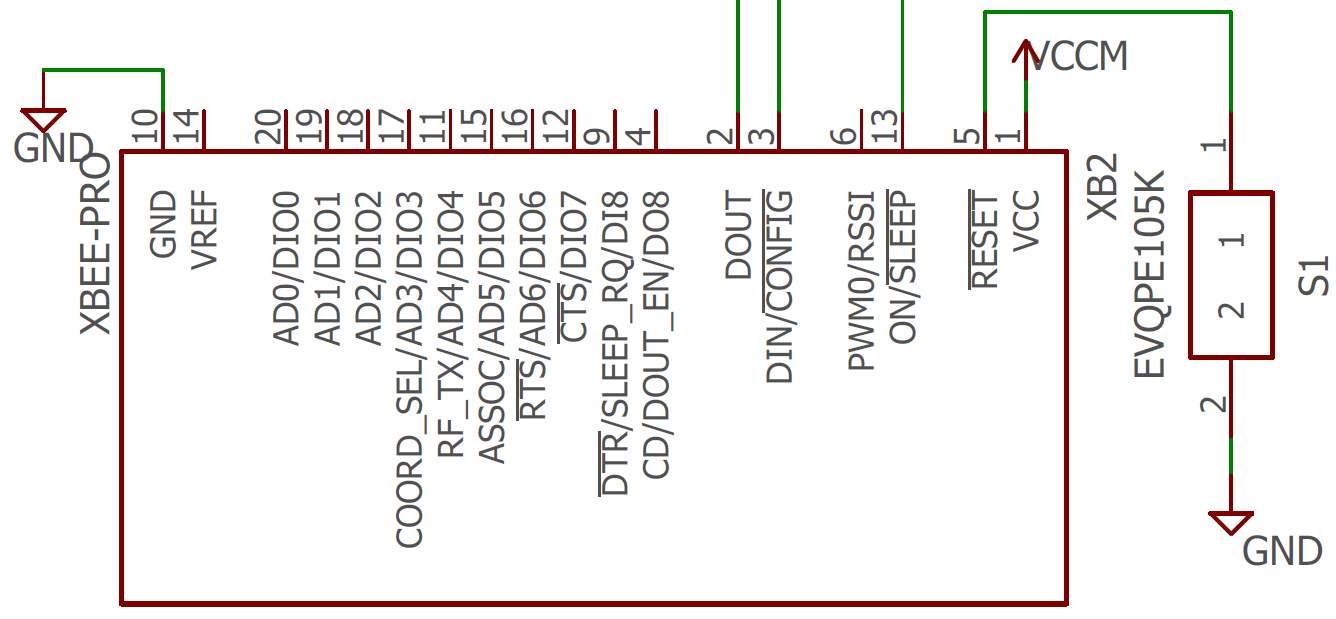
[picture p48: figure]

Figure 6 - ZigBee Transmitting Device

### 3.1.5. M5 & H5 Processors

There were two microcontrollers used in the design: the MK20DX128VLH5 and the MK20DX128VFM5 which will be referred to here after as the Primary and the SDA processors. As mentioned previously these two processors were selected as they were based off the FRDM board and are shown in Figure 7. These two processors required three oscillators shown in Figure 7 at frequencies of 32 kHz and 8 MHz.

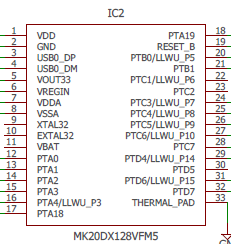
[picture p49: figure]
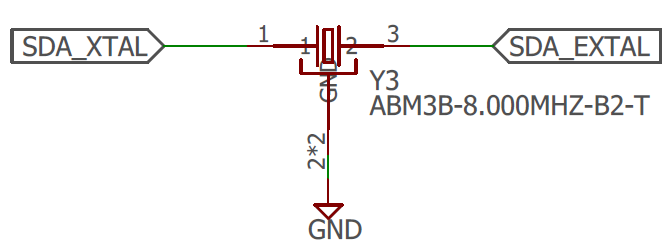
[picture p50: figure]
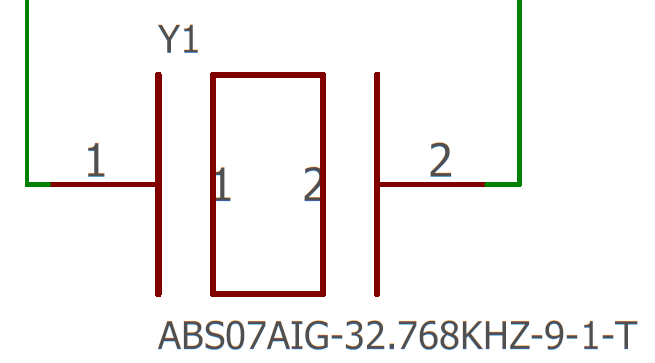
[picture p51: figure]

Figure 7 - Primary (left) and SDA (right) Processors and Oscillators (bottom right)

### 3.1.6. Mini-USB

The mini USB (Figure 8) was selected to allow connection to the SDA processor to convert the signals to serial to program the primary processor. The BZT52C15S Zener (D1) was installed to protect the board from high input transients and static. The L1 and L2 inductors or ferrite beads are installed to further decrease these effects.

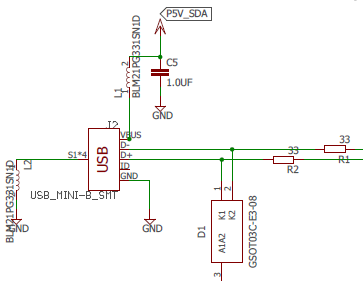
[picture p52: figure]

Figure 8 - Mini USB Circuit

### 3.1.7. JTAG and SDA Headers

The JTAG and SDA headers were installed to allow serial communication directly to both processors and are shown in Figure 9. The SDA header allowed communication to the primary processor and the JTAG header allowed communication to the SDA processor.

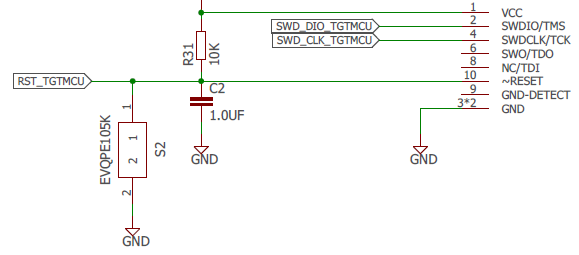
[picture p53: figure]
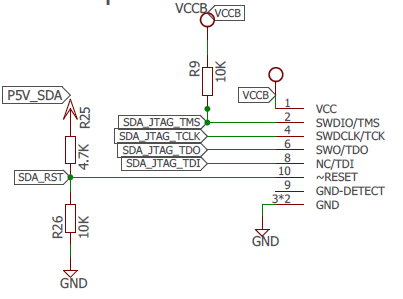
[picture p54: figure]

Figure 9 – SDA (left) and JTAG (right) Headers

### 3.1.8. 3-Stage Contingency

During the development of the CTM system it was decided to include stages on contingency due to the frontiers which were being pushed.

- Stage 1 Contingency was to essentially build the board in reference to headers which could be connected to a FRDM board. This meant the CTM could be inserted into a FRDM board and operate. This was achieved by connecting to FRDM headers (see Figure 11) all the input and outputs from the CTs. The CT circuits would receive power from the FRDM board and this supply rails was called the Backup (VCCB)

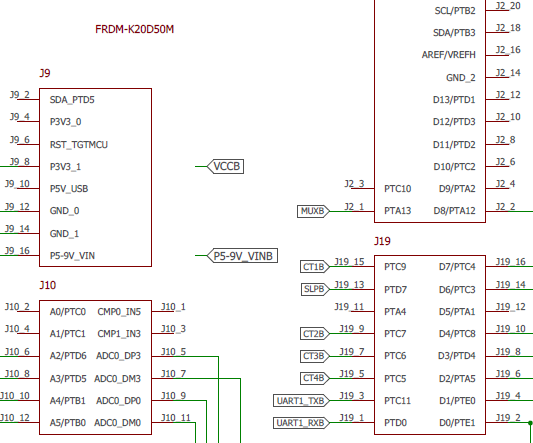
[picture p55: figure]

Figure 11 – FRDM Board Headers

- Stage 2 Contingency was having the primary processor drive the circuit connected across the FRDM headers by bridges. This circuit was powered by the CTM power supply and labelled the Main power supply (VCCM).
- Stage 3 Contingency was including the SDA chip and allowing the CTM to be programmed by mini USB interface.

### 3.1.9. Battery Sizing & Maximum Current (MICK)

The battery was isolated from the board by a 2-position dip switch which disconnected the positive and negative of the battery.

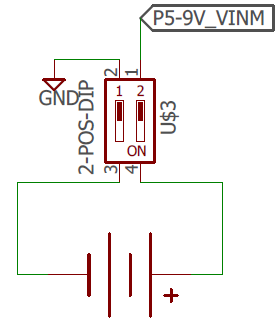
[picture p56: figure]

Figure 10 - Coin Cell Battery and Isolator

All electronic systems require power supplies to operate, Power management broadly refers to the generation and control of regulated voltages required to operate an electronic system. It encompasses much more than just power supply design. Today's systems require power supply design be integrated with the system design to maintain high efficiency

Integrated circuit components such as switching regulators, linear regulators, switched capacitor voltage converters, and voltage references are typical elements of power management.

The battery life of the circuit is determined by the battery capacity, which is the amount of current in total that the battery can supply during the lifetime of the battery and the load current of the circuit, the amount of current being consumed by the circuit. The first factor can be found by the manufacturer details of the battery which gives the capacity in amp-hours or milliamp- hours, the second factor requires to calculate the current drawn from the active devices in the circuit. The following formula is used to determine the battery life.

BatteryLife(Hours)=(Battery Capacity(Amp-hours))/(Current Draw (Amps))

#### 3.1.9.1. Battery Capacity

The Energizer 522 Alkaline 9-volt battery capacity is rated at 230 milliamp-hours at a 1000 milliamp discharge rate.

### 1.1.1. Power Saving

#### 3.1.9.2. Current Drawn

Operational Amplifiers

To determine the power draw of the op amp the quiescent current was obtained from the data sheet and the following formula used:

Power= (V_(cc)^(+) - V_(cc)^(-) )*I_q

The data sheet provided a typical value and a maximum value for the quiescent current, each value was used to obtain the power of the op amp with the max value used as a worst-case scenario.

I_q typical=0.5 mA V_(cc)^(+) =3.3 volts

I_q max=1.2 mA V_(cc)^(-) =0

Power_(typical) =(3.3-0)*0.5×10^(-3)

Power_(typical) =1.65 mW per Op-Amp

Power_(maximum) =(3.3-0)*1.2×10^(-3)

Power_(maximum) =3.96mW per Op-Amp

The component is a dual Op-Amp package therefore each package will draw 2.4 mA and the board has 4 in total resulting in 9.6mA.

Voltage Regulator

The maximum package power dissipation of the NCP1117LP voltage regulator is given by the formula:

P_D =(T_(J(max)) -T_A)/(R_(θJA))

T_(J(max)) is the maximum junction temperature range =150 °C

T_A is the operating ambient temperature range =25℃

R_(θJA) is the thermal Resistance, Junction−to−Ambient =108℃/W

The maximum power P_D =(150-25)/108

P_D =1.15W

The maximum current output of the regulator is I=P/V where V is the voltage drop of the regulator. V=9-3.3=5.7V

I=1.15/5.7

I=201.75mA

To calculate a typical power rating of the voltage regulator it is somewhat hidden within the datasheet. It can be calculated by looking at the following related specifications.

T_(OP) is the operating junction temperature range =0-125 °C

R_(θJC) is the thermal resistance junction-to-case =15℃/W

R_(θJA) is the thermal resistance, junction−to−ambient =108℃/W

T_(OP) specifies how hot the “junction”, the active part of the regulator can get before it goes into thermal shutdown. R_(θJC) specifies how much temperature difference to be expected between the junction and the outside of the package. This is relevant if you can quickly remove heat from the package. A perfect coupled heat sink hooked to your package, for each Watt the junction temperature would rise only 15℃ above the temp of the heat sink. R_(θJA) is how hot the junction gets when the regulator is dissipating a given amount of power and the regulator is sitting at a given ambient temperature. We design our regulator to work under modest commercial conditions such that it will not exceed 60 ℃ and the junction temperature needs to stay below 125 °C, then the maximum temperature rise allowable is 125-60=65℃. The power dissipation is given by:

P=(65℃)/(R_(θJA))

P=65/108

P=0.602W

The current is I=P/V

I=0.602/5.7

I=106mA

XBee Pro

The XBee Pro attached to the board will draw current during transmission and when in its sleep mode. The maximum current draw will be transmission mode with the data sheet quoting a transmit current of 205mA. The power down current of the XBee is 3.5μA.

MK20DX128VLH5 and MK20DX128VFM5 processors.

The absolute maximum ratings for the MK20DX128VFM5 and MK20DX128VLH5 are obtained from the device datasheet. The maximum power supply current I_(DD) , includes all current being sourced by the microcontroller pins in addition to the current used to operate the CPU and peripherals. For the MK20DX128VLH5 and MK20DX128VFM5 the

I_(DD) =155 mA

SN74LVC125A Quadruple Bus Buffer Gate

The absolute maximum current draw of the SN74LVC125A was calculated from the manufacturers datasheet by adding the continuous input current and the output current.

I_(max) =50mA+100mA

I_(max) =150mA

HEF4066B Quad single-pole single-throw analog switch(Multiplexer)

The max supply current at worst case scenario for the Multiplexer was 7.5μA when the device is operating at an ambient temperature of 125℃ .

Mini USB

The specifications of USB 2.0 states that the maximum current draw is 100mA .

LED’s

The current drawn from the LED’s can be found using the formula:

R=(V_s -V_f)/i

V_s =3.3V Supply voltage

V_f =2.6V LED forward voltage drop (found in datasheet)

R=220 Ω Resistor value

i= (3.3-2.6)/220

i=3.18mA

The board has a total of 6 LED’s taken the worst case that all LED’s are on at the same time the total current draw

I=3.18 ×6

I=19.08 mA

The table below shows the total maximum current for each component. These values are a worst-case scenario in which the absolute maximum current would be supplied to each component. The battery life calculation will be done using the worst-case scenario for each component, assuming that all components are at maximum draw at the same time and operating all the time. The total is 995.3875mA , which is approximately 1000mA.

U ing the battery life equation:

BatteryLife(Hours)=(Battery Capacity(Amp-hours))/(Current Draw (Amps))

BatteryLife(Hours)=(230(milliamp-hours))/(1000 (milliamps))

BatteryLife(Hours)=0.23 hours

Component | Maximum Current (mA)
Op Amps | 9.6
Voltage Regulator | 201.7
XBee Pro | 205
MK20DX128VLH5 | 155
MK20DX128VFM5 | 155
Quadruple Bus Buffer Gate | 150
Quad single-pole single-throw analog switch(Multiplexer) | 0.0075
LED’s | 19.08
Mini USB | 100
| Total = 995.3875

## 3.2. PCB Design

The selected method of layout approach for the PCB was trial and error. This approach allowed many designs to be made, consuming copious amounts and time, and delivering maximum returns in the form of stress. The size of the board was limited to 80x100 mm as this is the maximum allowable board size in the free version of eagle. This proved challenging in the creation of the PCB.

All the components were placed on the board and it was auto-routed to give an indication of placement pattern. The result yielded 84.2 % routed (see Figure 12), which was not high and indicated poor placement. It was decided to place all the components and route manually.

Figure 12 - Auto Routed Test of Placement

All of the components were successfully placed but the SDA processor which had 32 pins and proved difficult routing which originally could not be routed as indicated by the three air wires in Figure 13.

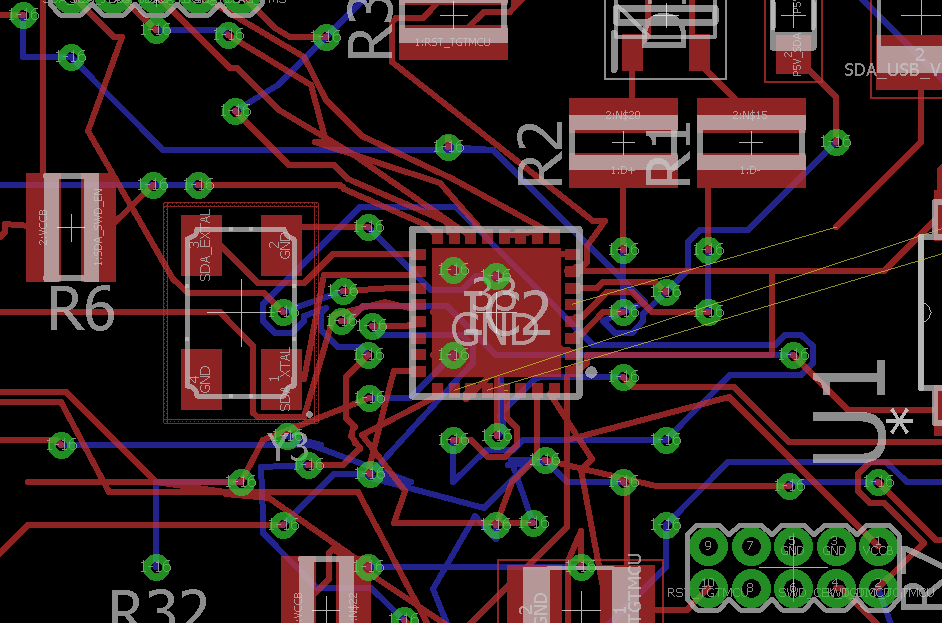
[picture p57: figure]

Figure 13 - SDA Processor with Poor Routing

Routing manually allowed for the optimal placement of the components, this included:

A. Placing all the CT circuits in their individual circuits off to the side
B. Increasing the free space around each processor for routing
C. Allow room between the FRDM headers for routing around the outside
D. Placing the power supply together in a corner
E. Relocating the USB outside of the FRDM Headers

The finished PCB is shown in Figure 14 and the areas of noted above are shown with their corresponding letters.

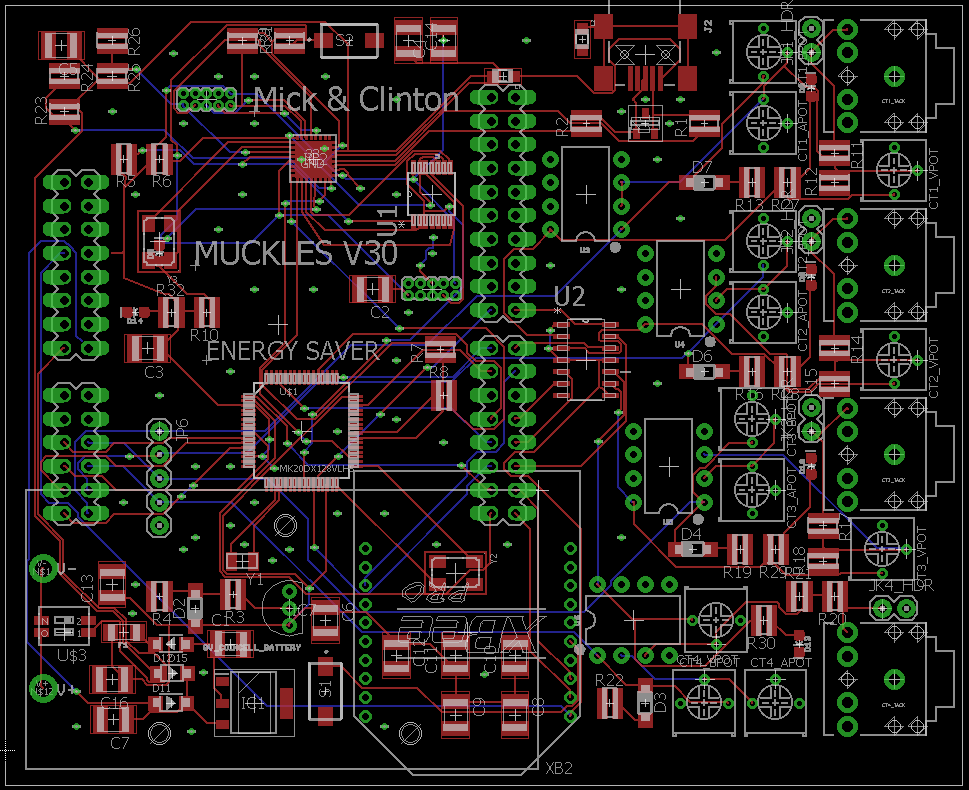
[picture p58: figure]

B

E

B

A

D

C

Figure 14 - Finished PCB

# 4. SOFTWARE DESIGN

## 4.1. Kinetis Code

### 4.1.1. Analog to Digital Converter

The Kinetis code was developed by adding on each task successively. The first step was to setup the project and get it receiving data from the channels. The pins for the Analog to Digital Converter (ADC) channels were setup when designing the schematic. The advantage of using FRDM-K20D50M processor was the familiarity with the syntax of C and the onboard ADC.

### 4.1.2. Timing

Figure 15 shows the operation of the circuit with respect to timing and defines a phase, cycle and period (note the units are seconds).

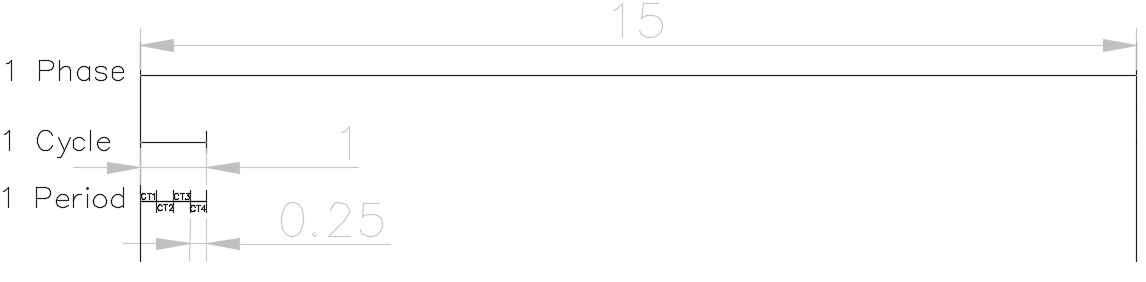
[picture p59: figure]

Figure 15 - Definition of Timing in Circuit (seconds)

Figure 15 shows there were three loops timing sessions occurring; a phase, a cycle, and a period. The program was sent into a wait for interrupt phase on startup while enabling Timer 1 which was a 15 second timer that timed a phase. This would interrupt and disable itself starting Timer 2. Timer 2 would interrupt itself every 1ms and on each interrupt a piece of data would be captured. After 250 of these data acquisitions a switch statement would turn on another channel until all channels were had data recorded. The switch statement would turn on a single channel at a time. A minimum value was set up that if a channel did not read above a (xx) minimum value then it was disabled for 40 phases which was 10 minutes.

### 4.1.3. Data Percentage

The values to for each channel were sent to a putty to verify when testing and display the state of each channel. This was important during the calibration phase and a clipping range was introduced. This clipping function occurred if the input ranges of the ADC were above 3.300 V which translated to 16-bit number of 65,535- 0, while a buffer of 100 was placed on each side shifting it to 65,435-100. It was decided that it was easier to map this to a percentage which could be calibrated to the type of sensor (10A, 20A or 25A) during setup. This removed the necessary gain adjustment.

### 4.1.4. Data Calculation

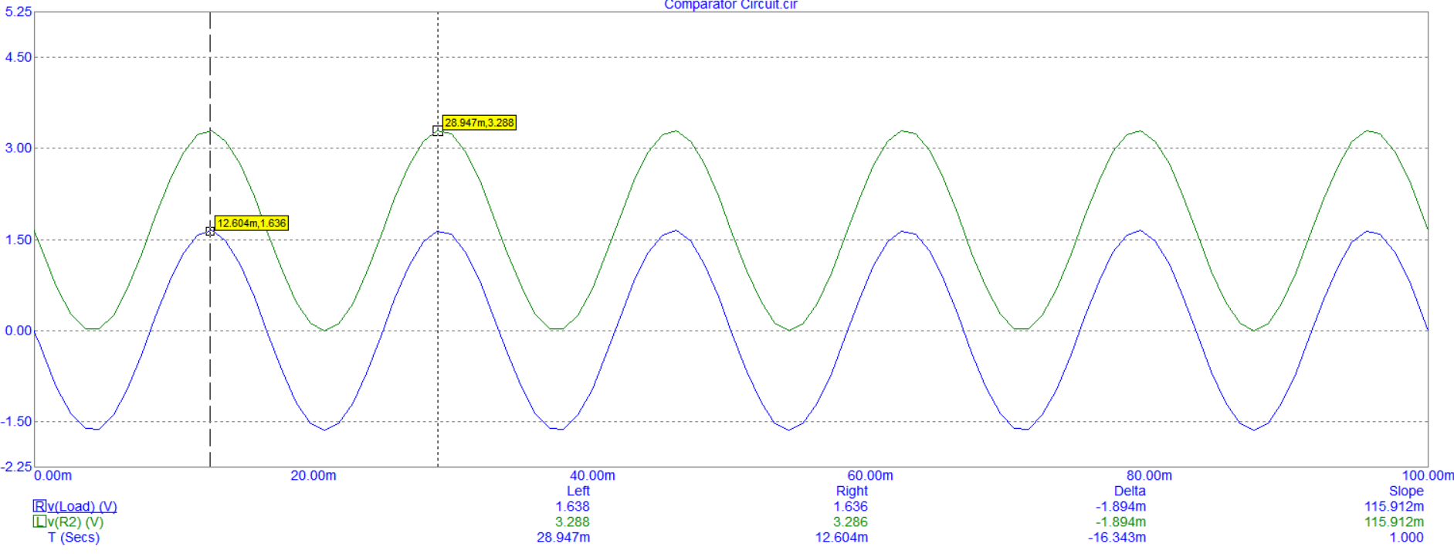
[picture p60: figure]

The data for a period was summed for each point of the 250.

The equations for RMS here ?

### 4.1.5. ZigBee Transmission (MICK)

The transmission of the data over the Xbee module will be done by placing the data into array and using the Asynchroserial function to send one character at a time. The code shows the current sensor values placed into the buffer named message with the strlen function assigning the message size which is important before the API structures can be constructed.

static char message [100];

snprintf(message,100,"%f,%f,%f,%f\n",CT_Current[0],CT_Current[1],CT_Current[2],CT_Current[3]);

int message_size = strlen(message);

Xbee’s provide a mode called Application Programming Interface (API) which provides uses with a structured interface where data is communicated the serial interface in orgnised packets in a determined order. Data transmitted in the form of API packets or data frames have a very well define structure and understanding this structure is crucial to derive data from the frame.

An API frame has the following structure

Start Delimiter | Length | | Frame Data | | | | | | | | Checksum
1 | 2 | 3 | 4 | 5 | 6 | 7 | 8 | 9 | … | n | n+1
0x7E | MSB | LSB | API-specific structure | | | | | | | | Single byte

The specific structures can be found by connecting the Xbee to the XCTU program whilst the specific data is being sent. The picture below shows the API structures for the CT Monitoring Assignment.

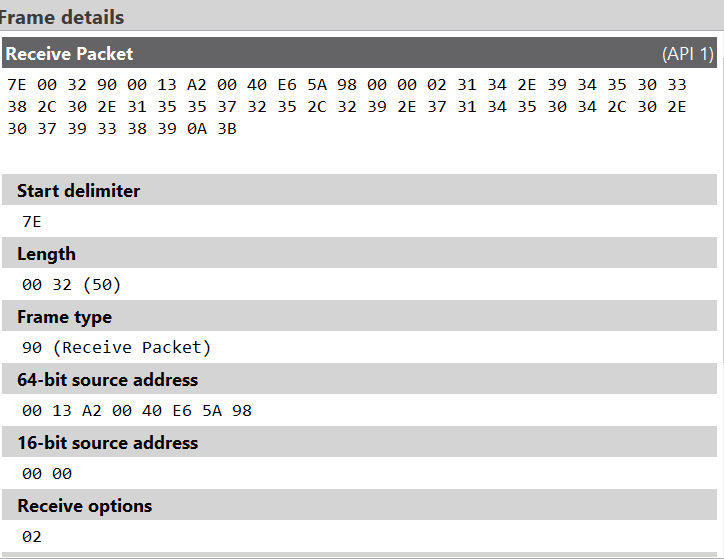
[picture p61: figure]
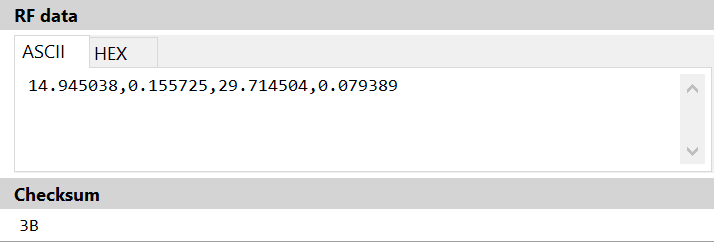
[picture p62: figure]

This information is used to write the code in kinetis to construct the Xbee API packet as shown below.

// Construct the Xbee API frame packet

byte packet [128];

packet[0] = 0x7E; // Start delimiter

packet[1] = 0x00; packet[2] = (byte)(message_size + 14); // Frame length

packet[3] = 0x10; // Frame type: Transmit request

packet[4] = 0x01; // Frame ID

packet[5] = 0x00; packet[6] = 0x00;

packet[7] = 0x00; packet[8] = 0x00;

packet[9] = 0x00; packet[10] = 0x00;

packet[11] = 0xFF; packet[12] = 0xFF; // 64 bit destination address: Broadcast

packet[13] = 0xFF; packet[14] = 0xFE; // 16 bit destination address: Broadcast

packet[15] = 0x00; // Broadcast radius

packet[16] = 0x00; // Options: None

The message can then be placed into the frame packet once the API structures are established.

// Place message into frame packet

for (int i = 0; i < message_size; i++) {

packet[17 + i] = (byte)message[i];

}

The Checksum is the last byte of the frame and helps test the data integrity. To calculate the checksum of an API frame all the bytes of the packet excluding the start delimiter and length are added. The lowest 8 bits only are kept from this result and this quantity is subtracted from 0xFF. If the checksum is incorrect frames sent through the serial interface will never be processed. The Checksum calculation is shown below.

// Xbee API checksum calculation

uint8 checksum = 0xFF;

for (int i = 3; i < 17 + message_size; i++) {

checksum -= (uint8)packet[i];

}

packet[17 + message_size] = checksum;

The data can be sent using the asynchroserial fuction:

// Transmit one byte at a time

for(int i = 0; i < sizeof(packet); i++) {

while(AS1_SendChar((byte)packet[i]) != ERR_OK) {}

## 4.2. C++ Code

### 4.2.1. ZigBee Data Acquisition (MICK)

The receiving of the data packets on the raspberry pi required the use of unions and structures of the C++ programing language. A union in C programming is a user defined variable which may hold members of different sizes and type which all members share the same memory location. A structure is a convenient tool for handling a group of logically related data items. Structure help to organize complex data is a more meaningful way. The follow code was implemented to handle the Xbee protocol.

static union {

char buf [RXBUF_LENGTH];

struct __attribute__((packed)) {

uint8_t start_delimiter;

uint16_t length;

uint8_t frame_type;

uint64_t source_address_64;

uint16_t source_address_16;

uint8_t receive_options;

char rf_data[]; // up until the end of the union.

// There is a checksum field immediately after the end of rf_data.

} packet;

} rxbuf;

The incoming bytes are placed into rxbuf.buf[]. The struct rxbuf.packet allows for named access to particular fields within the binary protocol. The packet receive function was written with several if statements that reads from the serial port into rxbuf until a complete packet has been received. It returns the length of the data payload or -1 if receive failed. Before the loop of the function was run the buffer was zeroed and an index was initiated to 0.

memset(&rxbuf, 0, sizeof(rxbuf));

rxbuf_idx = 0;

The API frame structure is known, therefore within code there are checks, as we are expecting the start delimiter, the following was written:

if ((rxbuf_idx == 0) && (c != 0x7E)) {

this checks the data to see if the first byte is the expected start delimiter. If this does not occur we are not synchronised with the Xbee and we discard bytes by restarting this loop body until we see a start of frame delimiter. If the start delimiter is received then the characters are saved into the buffer. Once rxbuf_idx is 3, this acknowledges that we have received the length of the packet. The received packet length is in big endian format. Endianness refers to the sequential order in which bytes are arranged into larger numerical values, when stored in computer memory, or when transmitted over digital links.

rxbuf.packet.length = be16toh(rxbuf.packet.length);

When rxbuf_idx is greater or equal to 4 this indicates that the number of bytes received is rxbuf_idx, this is due to 4 bytes not being counted in length which are the start delimiter, the 2 bytes of length and checksum.

} else if (rxbuf_idx >= 4) {

The complete packet is received when we have the length plus 4 bytes.

if (rxbuf_idx >= rxbuf.packet.length+4) {

The function performs a number of checks including the check sum calculation, to confirm it is indeed the required data, the function returns the data by subtracting 12 off the length as there are 12 bytes of header included in packet.length.

return rxbuf.packet.length - 12;

### 4.2.2. WiPi Upload (MICK)

To connect the Pi to internet the Wi-Pi module needed to be configured to the network that we the device was operating through. The network configurations were modified in the command line editor to set up a wi-fi connection on the JCU network. transmitting the logged data is by sending specially crafted HTTP requests. A simple HTTP library is called “libcurl” is installed on the Pi. Libcurl is a free and easy-to-use client-side URL transfer library, it is a computer software project providing a library and command-line tool for transferring data using various protocols.

// Initialise the HTTP library

CURL *curl = curl_easy_init();

if (!curl) {

printf("Failed to initialise the curl library\n");

return 1;

}

curl_easy_setopt(curl, CURLOPT_WRITEFUNCTION, http_callback);

### 4.2.3. ThingSpeak Display (MICK)

The data stream was created by accessing the Thingspeak website, by signing up for a account, and creating a new channel at thingspeak.com/channels. Four independent data fields were specified as this corresponded to the four sensors to be read by the board. Once the channels are created the writing API key was found and copied into the code. The writing key is required to upload data to the channel, it provides a URL to use in the code.

// Scan the received data and construct url

sscanf(rxbuf.packet.rf_data, "%f,%f,%f,%f\n",&CT_Current0,&CT_Current1,&CT_Current2,&CT_Current3);

snprintf(url,500,"https://api.thingspeak.com/update?api_key=JYCQY04Q24PQWZPR&field1=%f&field2=%f&field3=%f&field4=%f",CT_Current0,CT_Current1,CT_Current2,CT_Current3);

printf("%s\n", url);

# 5. TESTING & DISCUSSION

## 5.1. Final Product

Table for calibration!!

## 5.2. Game-Day Performance

The entire circuit was then built onto.

# 6. LIMITATIONS & RECOMMENDATIONS

## 6.1. Limitations

## 6.2. Recommendations

Maybe zigbee switched on with the mux?

Use RTOS?

Better implementation of interrupts?

# 7. CONCLUSION

Project #1: non-invasive current metering

Using CT (current transformer) sensors, monitor the AC current in external circuits. CT sensors will be supplied that produce an AC voltage in proportion to the current being measured. You will sense this voltage and thereby calculate the current that is flowing.

Your system must be capable of simultaneously monitoring at least 4 circuits per microcontroller.

You must implement at least one of the following features:

• A sensor node that operates without access to mains electricity, e.g. using built-in batteries and/or scavenging power. If your device is battery powered then you do not need to implement wireless communication.

• Wireless communication between sensor node(s) and a base station, with near to real-time data upload to the Internet. Your base station will be a Raspberry Pi.

Hints:

• This project favours electronics and circuit design. You will need to implement some analog circuitry to sample the AC voltage, e.g. by DC biasing into the midpoint of the ADC range.

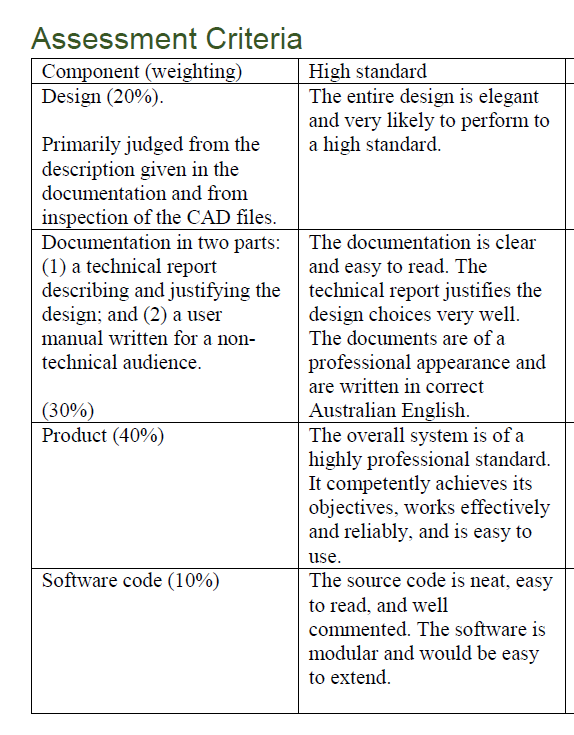
[picture p63: figure]

# 8. REFERENCES

[1] E. Hub. (2017, 17/10). Current Transformer. Available: http://www.electronicshub.org/current-transformer/

# LIST OF APPENDICES

# APPENDIX A – SCHEMATIC

# APPENDIX B – PCB LAYOUT

# APPENDIX C – BILL OF MATERIALS

# APPENDIX D – CODE

# APPENDIX E – FINAL PRODUCT

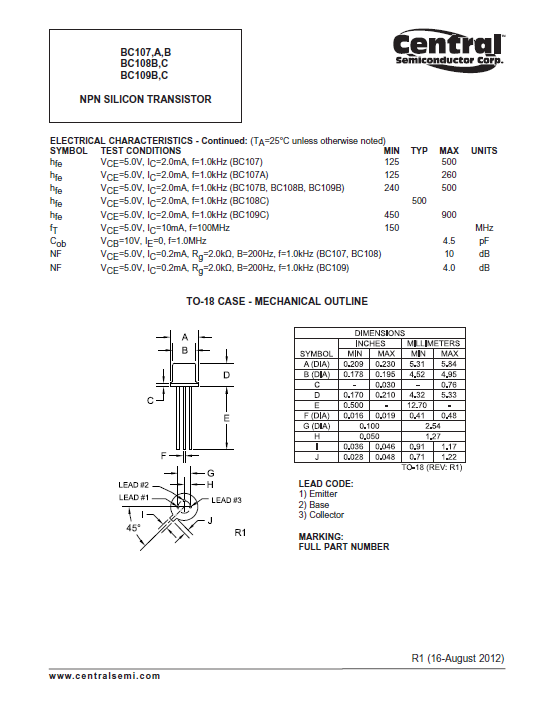
[picture p64: figure]

CLINTON ELLIOTT - 1278877 DCP-5000 18/10/2015

ELLIOTT - 12788727 CTM-3501 Schematic JCU
