clintonelliott23/CT-Monitoring-Assignment/CTM - Operational Images/20171019_153253.jpg

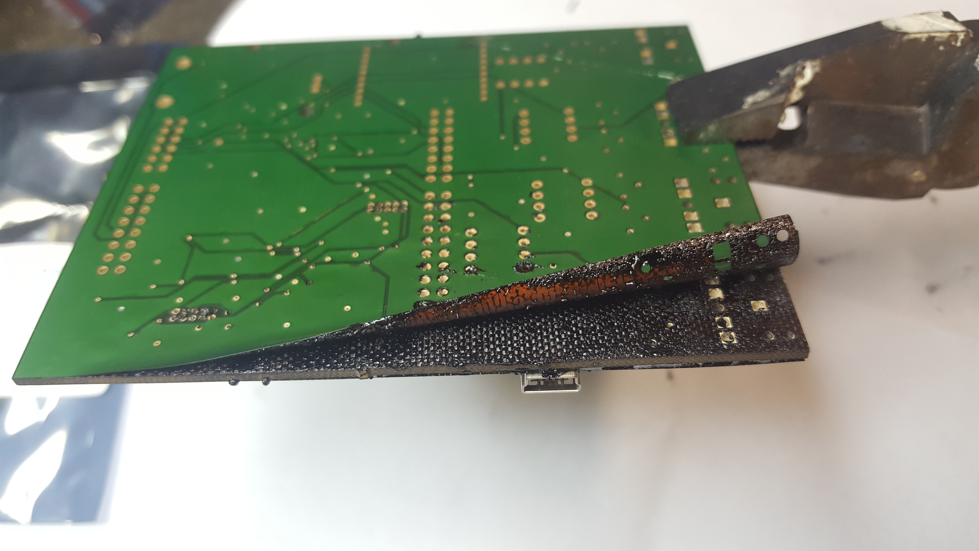
CTM - Operational Images/20171019_153253.jpg
