clintonelliott23/CT-Monitoring-Assignment/CTM - Operational Images/20171026_113317.jpg

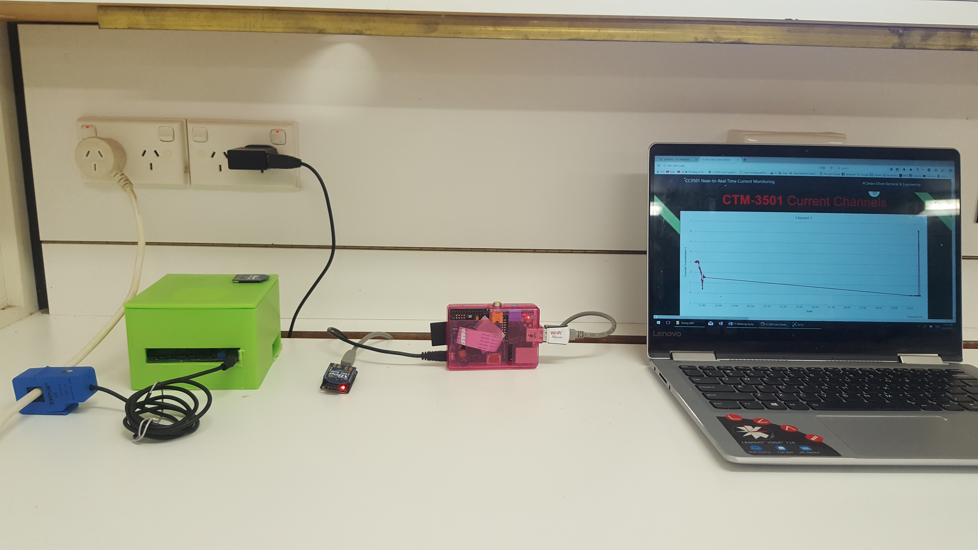
CTM - Operational Images/20171026_113317.jpg
