clintonelliott23/CT-Monitoring-Assignment/CTM - Operational Images/screenshot working.jpg

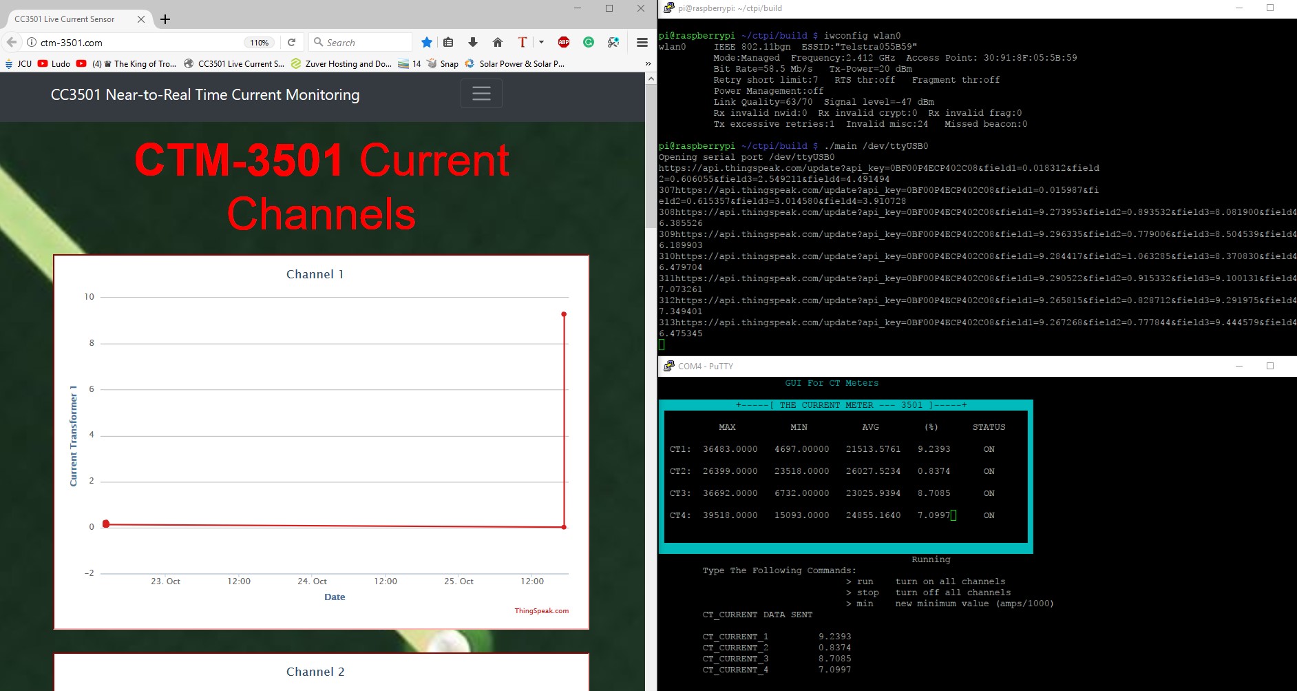
CTM - Operational Images/screenshot working.jpg
