clintonelliott23/CT-Monitoring-Assignment/CTM - Operational Images/current meter calibrations.xlsx

Verifed Current | Percentage Scaled From Kinetis |  |  |  |  | Average | amp/avg | avg/amp
 |  |  |  |  |  |  |  |  | Verifed Amps | CT % Avg | Amp/CT%Avg
0.2 | 1.15 | 1.11 | 1.63 | 1.56 | 1.39 | 1.368 | 0.1461988304 | 6.84 | 0.2 | 1.368 | 0.1461988304
0.2 | 1.26 | 1.2 | 1.3 | 1.44 | 1.21 | 1.282 | 0.1560062402 | 6.41 | 0.2 | 1.282 | 0.1560062402
 |  |  |  |  |  |  |  |  | 0.5 | 3.338 | 0.1497902936
0.5 | 3.51 | 3.23 | 3.62 | 3.18 | 3.15 | 3.338 | 0.1497902936 | 6.676 | 0.5 | 3.322 | 0.1505117399
0.5 | 3.24 | 3.43 | 3.66 | 3.23 | 3.05 | 3.322 | 0.1505117399 | 6.644 | 8.8 | 48.808 | 0.1802983118
 |  |  |  |  |  | 0 |  |  | 8.8 | 49.044 | 0.1794307153
 |  |  |  |  |  |  |  |  | Scaling Factor | = | 0.1603726885
 |  |  |  |  |  | 0
 |  |  |  |  |  | 0
8.8 | 48.94 | 48.71 | 48.77 | 48.84 | 48.78 | 48.808 | 0.1802983118 | 5.546363636
 |  |  |  |  |  | 0
8.8 | 49.94 | 48.86 | 48.88 | 48.65 | 48.89 | 49.044 | 0.1794307153 | 5.573181818
 |  |  |  |  |  | 0
 |  |  |  |  |  | 0
 |  |  |  |  |  | 0 | 0.1603726885
 |  |  |  |  |  | 0
 |  |  |  |  |  | 0
 |  |  |  |  |  | 0
 |  |  |  |  |  | 0
 |  |  |  |  |  | 0
 |  |  |  |  |  | 0
 |  |  |  |  |  | 0
 |  |  |  |  |  | 0
 |  |  |  |  |  | 0
