clintonelliott23/CT-Monitoring-Assignment/CTM - PCB, Schematic & BOM/CT_Metering_Assignment-V_33_error checked for online.pdf

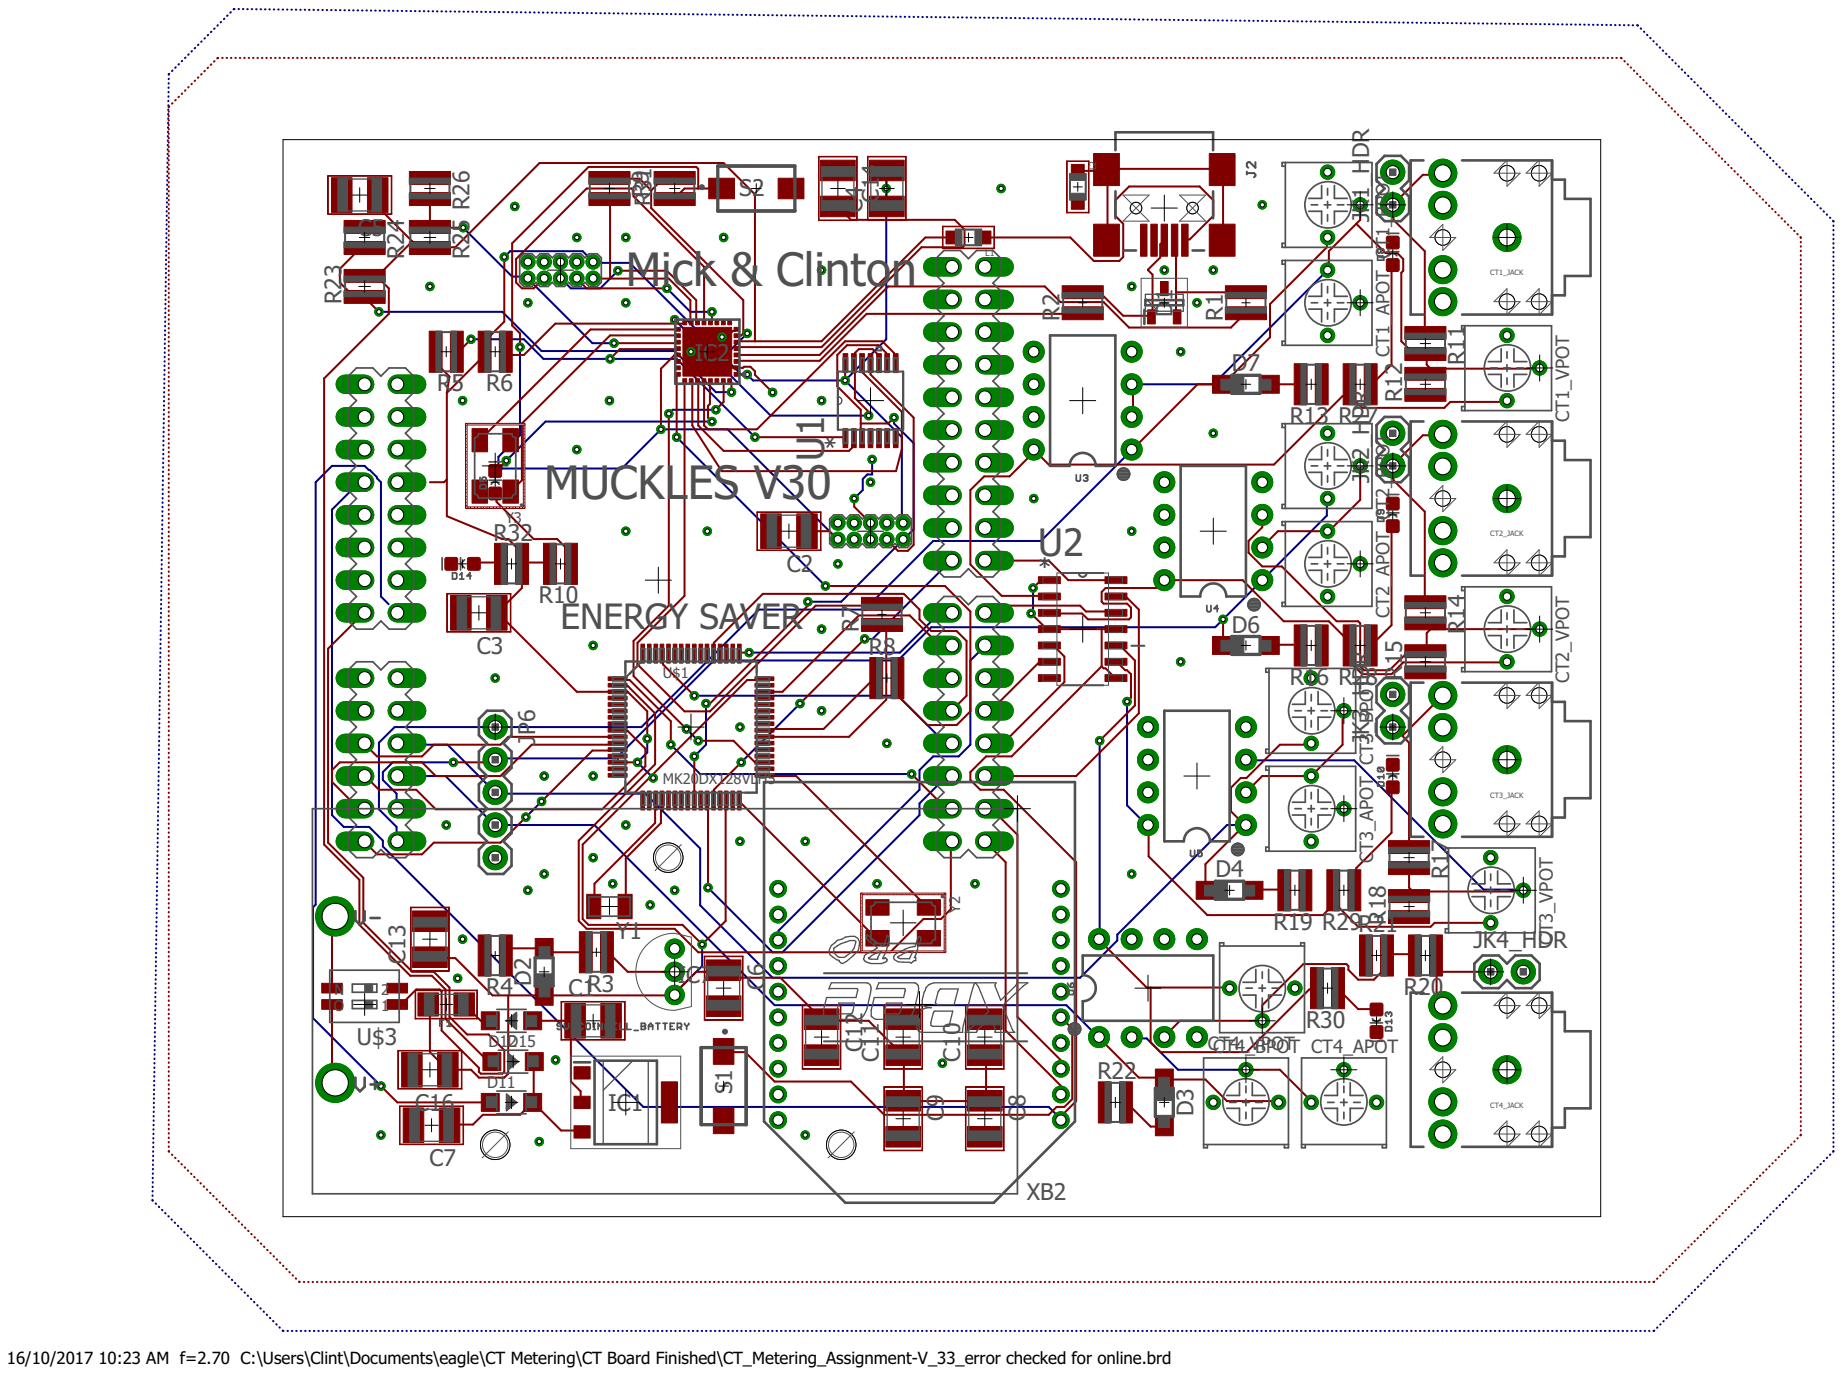
[picture p85: page 1]

16/10/2017 10:23 AM f=2.70 C:\Users\Clint\Documents\eagle\CT Metering\CT Board Finished\CT_Metering_Assignment-V_33_error checked for online.brd
