clintonelliott23/CT-Monitoring-Assignment/CTM - PCB, Schematic & BOM/CT_Metering_Assignment-V_33_page1.pdf

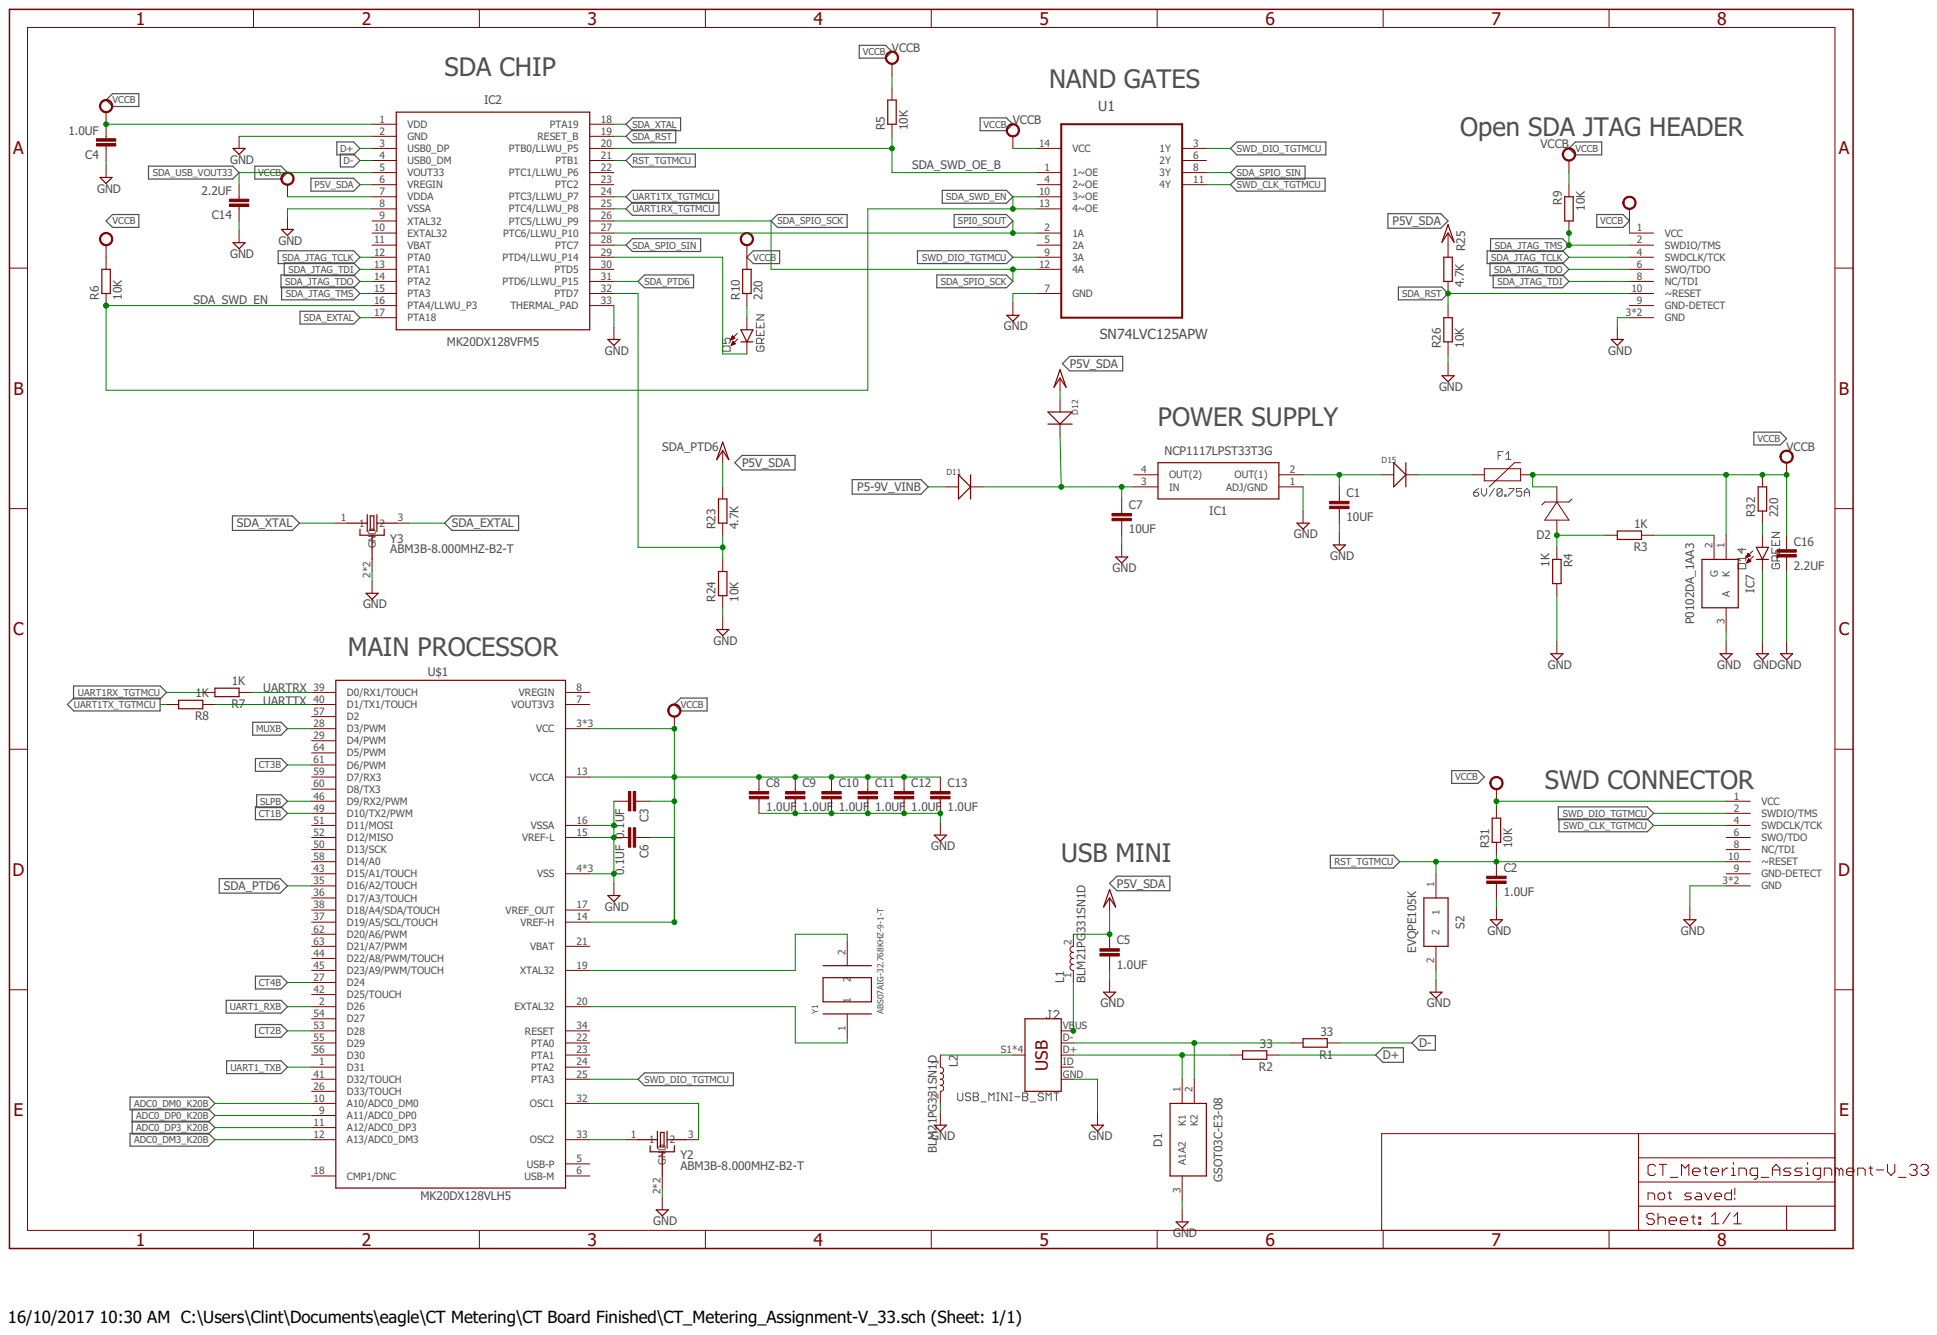
[picture p86: page 1]

Open SDA JTAG HEADER

16/10/2017 10:30 AM C:\Users\Clint\Documents\eagle\CT Metering\CT Board Finished\CT_Metering_Assignment-V_33.sch (Sheet: 1/1)
