clintonelliott23/CT-Monitoring-Assignment/CTM - PCB, Schematic & BOM/CT_Metering_Assignment-V_33_error checked for online.brd

## EAGLE design CTM - PCB, Schematic & BOM/CT_Metering_Assignment-V_33_error checked for online.brd (2017-10-29)

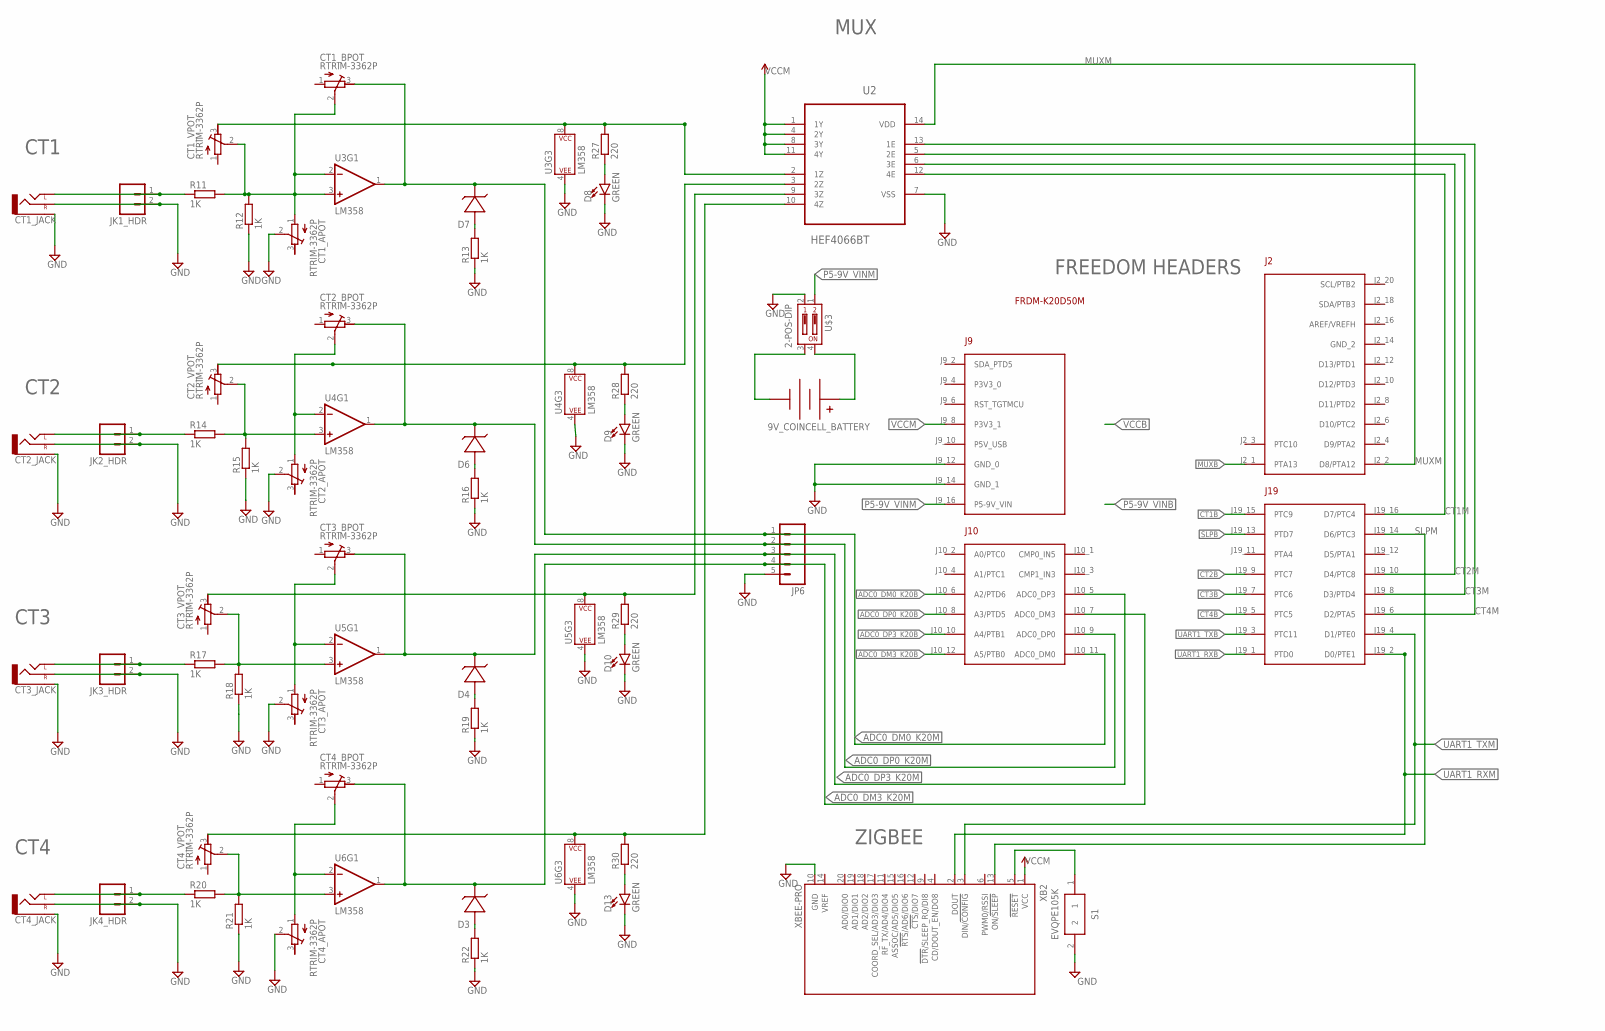
[picture p88: schematic CT_Metering_Assignment-V_33_error checked for online.sch, part in row 1, column 1]

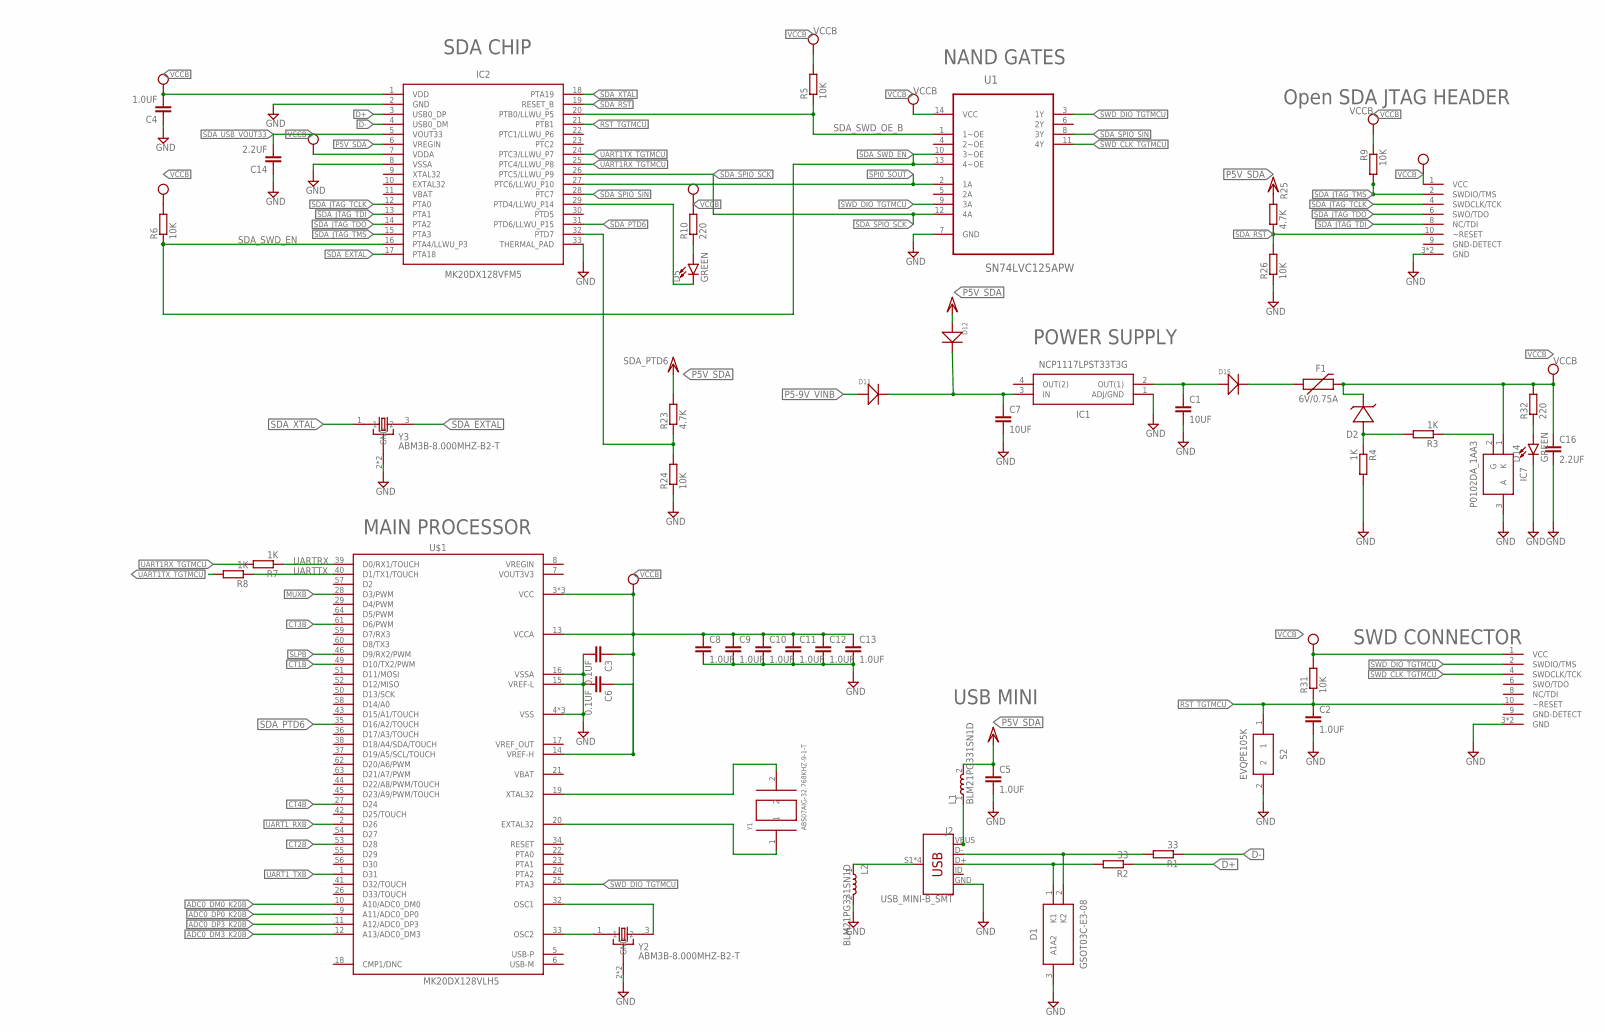
[picture p89: schematic CT_Metering_Assignment-V_33_error checked for online.sch, part in row 1, column 2]

Parts:
9V_COINCELL_BATTERY: BC9VPC
C1, C7: 10UF; C1210
C2, C4, C5, C8, C9, C10, C11, C12, C13: 1.0UF; C1210
C3, C6: 0.1UF; C1210
C14, C16: 2.2UF; C1210
CT1_APOT, CT1_BPOT, CT1_VPOT, CT2_APOT, CT2_BPOT, CT2_VPOT, CT3_APOT, CT3_BPOT, CT3_VPOT, CT4_APOT, CT4_BPOT, CT4_VPOT: RTRIM-3362P; RTRIM3362P
CT1_JACK, CT2_JACK, CT3_JACK, CT4_JACK: AUDIO-JACKPTH; AUDIO-JACK
D1: GSOT03C-E3-08; SOT100P248X115-3N
D2, D3, D4, D6, D7: ZENER; SOD123
D5, D8, D9, D10, D13, D14: GREEN; LED-0603
D11, D12, D15: 20V-1A; SOD-123
F1: 6V/0.75A; 1206
FRDM1: FRDM-K20D50M
IC1: NCP1117LPST33T3G; SOT230P700X180-4N
IC2: MK20DX128VFM5; SOT617-14
IC7: P0102DA_1AA3; TO-92
J2: USB_MINI-B_SMT; USB-MINIB
JK1_HDR, JK2_HDR, JK3_HDR, JK4_HDR: M02PTH; 1X02
JP6: M05PTH; 1X05
L1, L2: BLM21PG331SN1D; INDC2012X87
R1, R2: 33; PRL1632
R3, R4, R7, R8, R11, R12, R13, R14, R15, R16, R17, R18, R19, R20, R21, R22: 1K; PRL1632
R5, R6, R9, R24, R26, R31: 10K; PRL1632
R10, R27, R28, R29, R30, R32: 220; PRL1632
R23, R25: 4.7K; PRL1632
S1, S2: EVQPE105K; EVQPE1
U1: SN74LVC125APW; SOP65P640X120-14N
U2: HEF4066BT; SOIC127P600X175-14N
U3, U4, U5, U6: LM358; DIP08
U$1: MK20DX128VLH5; QFP50P1200X1200X160-64N
U$2: 2X5_0.05"_CORTEX_DEBUGTH_NOKEY_UNSHROUDED; 2X5_0.05"_TH_NS
U$3: 2-POS-DIP; CHS-02A
U$6: SWD HHEADER; 2X5_0.05"_TH_NS
XB2: XBEE-PRO
Y1: ABS07AIG-32.768KHZ-9-1-T; XTAL320X150X90
Y2, Y3: ABM3B-8.000MHZ-B2-T; OSCSC500X320X110-4N

Connections:
ADC0_DM0_K20B: FRDM1.J10_6 (A2/PTD6), U$1.10 (A10/ADC0_DM0)
ADC0_DM0_K20M: CT1_BPOT.3, D7.C (-), FRDM1.J10_11 (ADC0_DM0), JP6.1, U3.1 (OUT)
ADC0_DM3_K20B: FRDM1.J10_12 (A5/PTB0), U$1.12 (A13/ADC0_DM3)
ADC0_DM3_K20M: CT4_BPOT.3, D3.C (-), FRDM1.J10_7 (ADC0_DM3), JP6.4, U6.1 (OUT)
ADC0_DP0_K20B: FRDM1.J10_8 (A3/PTD5), U$1.9 (A11/ADC0_DP0)
ADC0_DP0_K20M: CT2_BPOT.3, D6.C (-), FRDM1.J10_9 (ADC0_DP0), JP6.2, U4.1 (OUT)
ADC0_DP3_K20B: FRDM1.J10_10 (A4/PTB1), U$1.11 (A12/ADC0_DP3)
ADC0_DP3_K20M: CT3_BPOT.3, D4.C (-), FRDM1.J10_5 (ADC0_DP3), JP6.3, U5.1 (OUT)
CT1B: FRDM1.J19_15 (PTC9), U$1.49 (D10/TX2/PWM)
CT1M: FRDM1.J19_16 (D7/PTC4), U2.12 (4E)
CT1_PWR: CT1_VPOT.3, R27.2, U2.2 (1Z), U3.8 (P$V+)
CT2B: FRDM1.J19_9 (PTC7), U$1.53 (D28)
CT2M: FRDM1.J19_10 (D4/PTC8), U2.6 (3E)
CT2_PWR: CT2_VPOT.3, R28.2, U2.3 (2Z), U4.8 (P$V+)
CT3B: FRDM1.J19_7 (PTC6), U$1.61 (D6/PWM)
CT3M: FRDM1.J19_8 (D3/PTD4), U2.5 (2E)
CT3_PWR: CT3_VPOT.3, R29.2, U2.9 (3Z), U5.8 (P$V+)
CT4B: FRDM1.J19_5 (PTC5), U$1.27 (D24)
CT4M: FRDM1.J19_6 (D2/PTA5), U2.13 (1E)
CT4_PWR: CT4_VPOT.3, R30.2, U2.10 (4Z), U6.8 (P$V+)
D+: IC2.3 (USB0_DP), R2.1
D-: IC2.4 (USB0_DM), R1.1
EXTAL32: U$1.20 (EXTAL32), Y1.1
GND: C1.2, C2.2, C3.2, C4.1, C5.2, C6.2, C7.2, C8.2, C9.2, C10.2, C11.2, C12.2, C13.2, C14.1, C16.2, CT1_APOT.2, CT1_JACK.RING (RIGHT), CT1_JACK.SLEEVE, CT2_APOT.2, CT2_JACK.RING (RIGHT), CT2_JACK.SLEEVE, CT3_APOT.2, CT3_JACK.RING (RIGHT), CT3_JACK.SLEEVE, CT4_APOT.2, CT4_JACK.RING (RIGHT), CT4_JACK.SLEEVE, D1.3 (A1A2), D8.C, D9.C, D10.C, D13.C, D14.C, FRDM1.J9_12 (GND_0), FRDM1.J9_14 (GND_1), IC1.1 (ADJ/GND), IC2.2 (GND), IC2.8 (VSSA), IC2.33 (THERMAL_PAD), IC7.3 (A), J2.GND, JK1_HDR.2, JK2_HDR.2, JK3_HDR.2, JK4_HDR.2, JP6.5, L2.2, R4.2, R12.1, R13.1, R15.1, R16.1, R18.1, R19.1, R21.1, R22.1, R24.1, R26.1, S1.2, S2.2, U1.7 (GND), U2.7 (VSS), U3.4 (P$V-), U4.4 (P$V-), U5.4 (P$V-), U6.4 (P$V-), U$1.4 (VSS), U$1.15 (VREF-L), U$1.16 (VSSA), U$1.31 (VSS), U$1.47 (VSS), U$2.3 (GND), U$2.5 (GND), U$3.2, U$6.3 (GND), U$6.5 (GND), XB2.10 (GND), Y2.2 (GND), Y2.4 (GND), Y3.2 (GND), Y3.4 (GND)
MUXB: FRDM1.J2_1 (PTA13), U$1.28 (D3/PWM)
MUXM: FRDM1.J2_2 (D8/PTA12), U2.14 (VDD)
unnamed: 9V_COINCELL_BATTERY.V-, U$3.3
unnamed: C1.1, D15.+, IC1.2 (OUT(1))
unnamed: D6.A (+), R16.2
unnamed: D15.-, F1.1
unnamed: D2.A (+), R3.2, R4.1
unnamed: D7.A (+), R13.2
unnamed: U$1.32 (OSC1), Y2.3 (2)
unnamed: U$1.33 (OSC2), Y2.1
unnamed: J2.S1 (SHIELD), J2.S2 (SHIELD), J2.S3 (SHIELD), J2.S4 (SHIELD), L2.1
unnamed: D4.A (+), R19.2
unnamed: CT2_VPOT.2, R14.2, R15.2, U4.3 (+IN)
unnamed: 9V_COINCELL_BATTERY.V+, U$3.4
unnamed: C7.1, D11.-, D12.-, IC1.3 (IN)
unnamed: D8.A, R27.1
unnamed: D1.2 (K2), J2.D-, R1.2
unnamed: IC7.2 (G), R3.1
unnamed: CT4_APOT.1, CT4_BPOT.2, U6.2 (-IN)
unnamed: D9.A, R28.1
unnamed: D3.A (+), R22.2
unnamed: D1.1 (K1), J2.D+, R2.2
unnamed: D5.C, IC2.29 (PTD4/LLWU_P14)
unnamed: D5.A, R10.1
unnamed: D10.A, R29.1
unnamed: S1.1, XB2.5 (!RESET)
unnamed: D13.A, R30.1
unnamed: CT1_APOT.1, CT1_BPOT.2, CT1_VPOT.2, R11.2, R12.2, U3.2 (-IN), U3.3 (+IN)
unnamed: D14.A, R32.1
unnamed: CT2_JACK.TIP (LEFT), JK2_HDR.1, R14.1
unnamed: CT2_APOT.1, CT2_BPOT.2, U4.2 (-IN)
unnamed: CT1_JACK.TIP (LEFT), JK1_HDR.1, R11.1
unnamed: IC2.32 (PTD7), R23.1, R24.2
unnamed: CT3_JACK.TIP (LEFT), JK3_HDR.1, R17.1
unnamed: CT3_VPOT.2, R17.2, R18.2, U5.3 (+IN)
unnamed: CT3_APOT.1, CT3_BPOT.2, U5.2 (-IN)
unnamed: CT4_JACK.TIP (LEFT), JK4_HDR.1, R20.1
unnamed: CT4_VPOT.2, R20.2, R21.2, U6.3 (+IN)
P5-9V_VINB: D11.+
P5-9V_VINM: FRDM1.J9_16 (P5-9V_VIN), U$3.1
P5V0_SDA_USB: J2.VBUS, L1.1
P5V_SDA: C5.1, D12.+, IC2.6 (VREGIN), L1.2, R23.2, R25.2
RST_TGTMCU: C2.1, IC2.21 (PTB1), R31.1, S2.1, U$6.10 (~RESET)
SDA_EXTAL: IC2.17 (PTA18), Y3.3 (2)
SDA_JTAG_TCLK: IC2.12 (PTA0), U$2.4 (SWDCLK/TCK)
SDA_JTAG_TDI: IC2.13 (PTA1), U$2.8 (NC/TDI)
SDA_JTAG_TDO: IC2.14 (PTA2), U$2.6 (SWO/TDO)
SDA_JTAG_TMS: IC2.15 (PTA3), R9.2, U$2.2 (SWDIO/TMS)
SDA_PTD6: IC2.31 (PTD6/LLWU_P15), U$1.35 (D16/A2/TOUCH)
SDA_RST: IC2.19 (RESET_B), R25.1, R26.2, U$2.10 (~RESET)
SDA_SPIO_SCK: IC2.26 (PTC5/LLWU_P9), U1.12 (4A)
SDA_SPIO_SIN: IC2.28 (PTC7), U1.8 (3Y)
SDA_SWD_EN: IC2.16 (PTA4/LLWU_P3), R6.1, U1.10 (3~OE), U1.13 (4~OE)
SDA_SWD_OE_B: IC2.20 (PTB0/LLWU_P5), R5.1, U1.1 (1~OE)
SDA_USB_VOUT33: C14.2, IC2.5 (VOUT33)
SDA_XTAL: IC2.18 (PTA19), Y3.1
SLPB: FRDM1.J19_13 (PTD7), U$1.46 (D9/RX2/PWM)
SLPM: FRDM1.J19_14 (D6/PTC3), XB2.13 (ON/!SLEEP)
SPI0_SOUT: IC2.27 (PTC6/LLWU_P10), U1.2 (1A)
SWD_CLK_TGTMCU: U1.11 (4Y), U$6.4 (SWDCLK/TCK)
SWD_DIO_TGTMCU: U1.3 (1Y), U1.9 (3A), U$1.25 (PTA3), U$6.2 (SWDIO/TMS)
UART1RX_TGTMCU: IC2.25 (PTC4/LLWU_P8), R7.2
UART1TX_TGTMCU: IC2.24 (PTC3/LLWU_P7), R8.2
UART1_RXB: FRDM1.J19_1 (PTD0), U$1.2 (D26)
UART1_RXM: FRDM1.J19_2 (D0/PTE1), XB2.2 (DOUT)
UART1_TXB: FRDM1.J19_3 (PTC11), U$1.1 (D31)
UART1_TXM: FRDM1.J19_4 (D1/PTE0), XB2.3 (DIN/!CONFIG)
UARTRX: R7.1, U$1.39 (D0/RX1/TOUCH)
UARTTX: R8.1, U$1.40 (D1/TX1/TOUCH)
VCCB: C3.1, C4.2, C6.1, C8.1, C9.1, C10.1, C11.1, C12.1, C13.1, C16.1, D2.C (-), F1.2, IC2.1 (VDD), IC2.7 (VDDA), IC7.1 (K), R5.2, R6.2, R9.1, R10.2, R31.2, R32.2, U1.14 (VCC), U$1.3 (VCC), U$1.13 (VCCA), U$1.14 (VREF-H), U$1.30 (VCC), U$1.48 (VCC), U$2.1 (VCC), U$6.1 (VCC)
VCCM: FRDM1.J9_8 (P3V3_1), U2.1 (1Y), U2.4 (2Y), U2.8 (3Y), U2.11 (4Y), XB2.1 (VCC)
XTAL32: U$1.19 (XTAL32), Y1.2

Notes on the sheet:
CT1
CT2
CT3
CT4
FREEDOM HEADERS
ZIGBEE
MUX
SWD CONNECTOR
USB MINI
POWER SUPPLY
SDA CHIP
NAND GATES
MAIN PROCESSOR
Open SDA JTAG HEADER

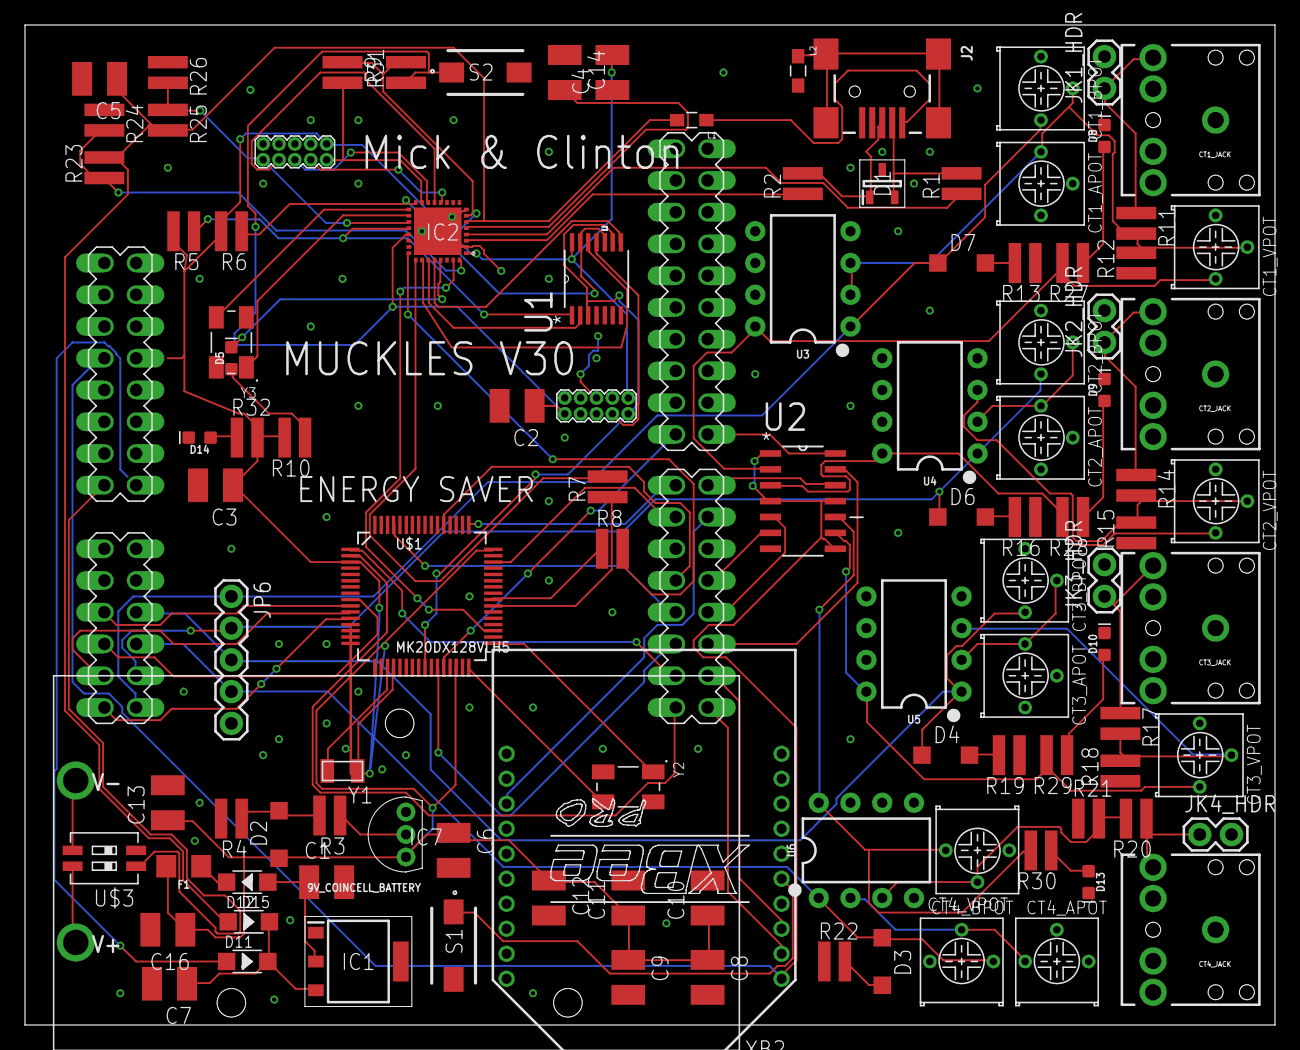
[picture p90: board CT_Metering_Assignment-V_33_error checked for online.brd from above]

Board: 2 copper layers, 100.0 x 80.0 mm, 108 parts (0 on the bottom side), 95 nets.
