clintonelliott23/CT-Monitoring-Assignment/(commit log)

2017-08-28 Setup File for Schematic
    Eagle file with frame
    [CT Metering R_1.sch]
2017-08-30 Learned Altium
    Started with Schematic Design and how to use Alitum
    Imported Libraries
    Have question about mirroring...
    [Axial Lead Diode.PcbLib, BC2032-F1.STEP, BGA_Rect.PcbLib, BGA_Sq_150P.PcbLib, BGA_Sq_40P.PcbLib, BGA_Sq_50P.PcbLib, BGA_Sq_65P.PcbLib, BGA_Sq_75P.PcbLib]
2017-08-30 Jake showed how to mirror
    [CT Metering Assingment.SchDoc]
2017-08-30 moved component
    [CT Metering Assingment.SchDoc, PCB_CT.PrjPcb]
2017-08-30 Moved Back
    [CT Metering Assingment.SchDoc]
2017-09-04 Updated things
    [Audio Jack schematic.SchDoc, CT_Entire_Project.PrjPcb, CT_MET_2.SchDoc, CT_PCB.PcbDoc, MK20DXschematic.SchDoc, Om Amp Level shifter schematic.SchDoc, Open SDA schematic.SchDoc, Power Supply schematic.SchDoc]
2017-09-04 added folder
    [Audio Jack schematic.SchDoc, CT_MET_2.SchDoc, CT_Project.PrjPcb, MK20DXschematic.SchDoc, Om Amp Level shifter schematic.SchDoc, Open SDA schematic.SchDoc, Power Supply schematic.SchDoc, XBEEPROschematic.SchDoc]
2017-09-05 Created CT Schematic
    :)
    [Audio Jack schematic.SchDoc, Audio_Jack_Attempt.PcbLib, CT_Project.PrjPcb, Passives.SchLib, SJ1-3533NG.PcbLib, SJ1-3533NG.SchLib]
2017-09-05 Cleaned up folder
    [Audio Jack schematic.SchDoc, CT Metering Assingment.SchDoc, CT Metering R_1.sch, CT_Entire_Project.PrjPcb, CT_MET_2.SchDoc, CT_PCB.PcbDoc, MK20DXschematic.SchDoc, Om Amp Level shifter schematic.SchDoc]
2017-10-29 Updated all shit
    ***Need to finish report
    [Audio Jack schematic.SchDoc, Audio_Jack_Attempt.PcbLib, Axial Lead Diode.PcbLib, BC2032-F1.STEP, BGA_Rect.PcbLib, BGA_Sq_150P.PcbLib, BGA_Sq_40P.PcbLib, BGA_Sq_50P.PcbLib]
2017-10-29 Need to Proof Report
    Mick is finishing off manual :)
    [CC3501-Bill-of-Materials-CT-Metering-PCB_Final.xlsx, CT_Metering_Assignment-V_33_error checked for online.brd, CT_Metering_Assignment-V_33_error checked for online.sch, current meter calibrations.xlsx]
