clintonelliott23/CT-Monitoring-Assignment/(notices)

Notices in the files:
CTM - Website HTML Code/README.md:
License: MIT
parts and their libraries:
SparkFun-Connectors: Licensing: Creative Commons ShareAlike 4.0 International - https://creativecommons.org/licenses/by-sa/4.0
