clintonelliott23/CT-Monitoring-Assignment/CTM - Operational Images/20171026_113354.jpg

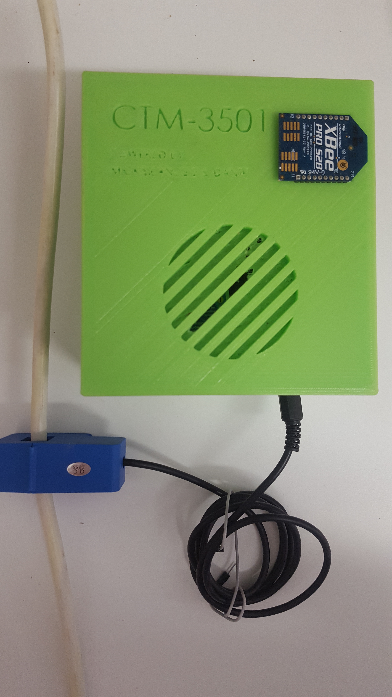
CTM - Operational Images/20171026_113354.jpg
